21317682/E344/Reports/Assignment 2/App-A.tex

     \chapter{Appendix A: GitHub Activity Heatmap}

     \begin{figure}[!htb]
     \centering
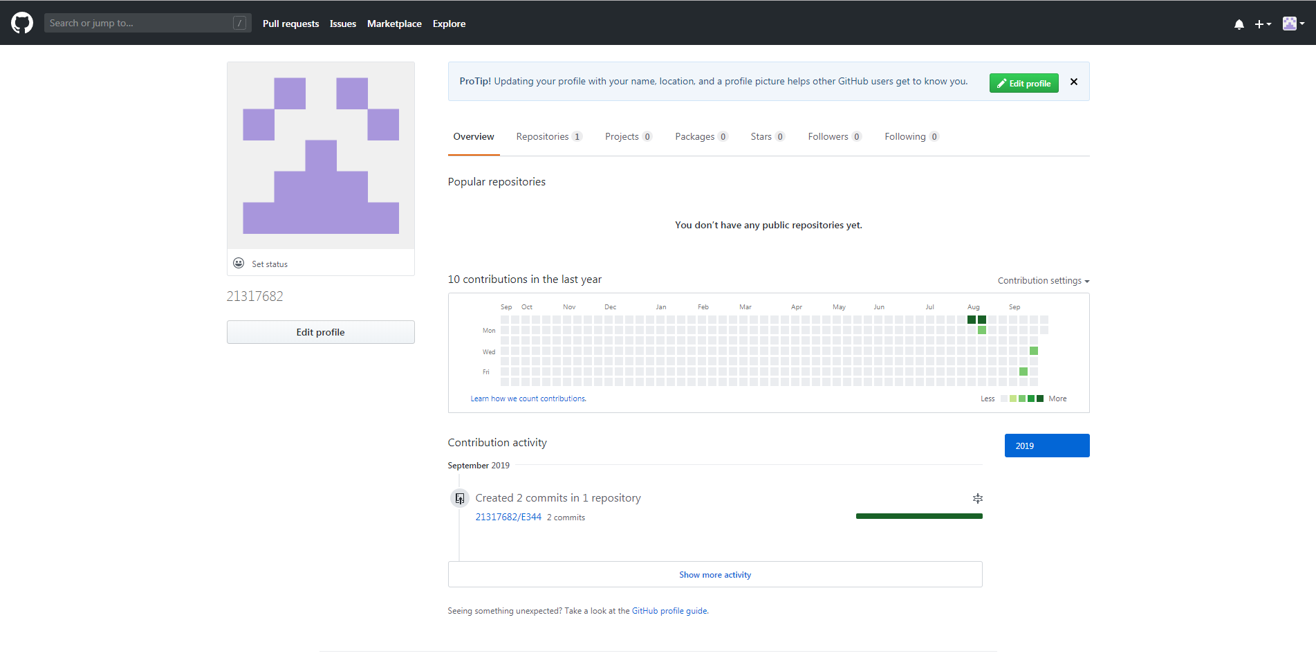
[picture p1: Reports/Assignment 2/Figures/heatmap.png]
     	\fbox{}
	\label{fig:github}
	\end{figure}
