21317682/E344/Reports/Assignment 2/declaration.tex

   \chapter{Declaration}

By submitting this report electronically, I declare that the entirety of the work contained
therein is my own, original work, that I am the sole author thereof (save to the extent
explicitly otherwise stated), that reproduction and publication thereof by Stellenbosch
University will not infringe any third party rights and that I have not previously in its
entirety or in part submitted it for obtaining any qualifcation.

\vspace{3cm}
\hspace{2cm}
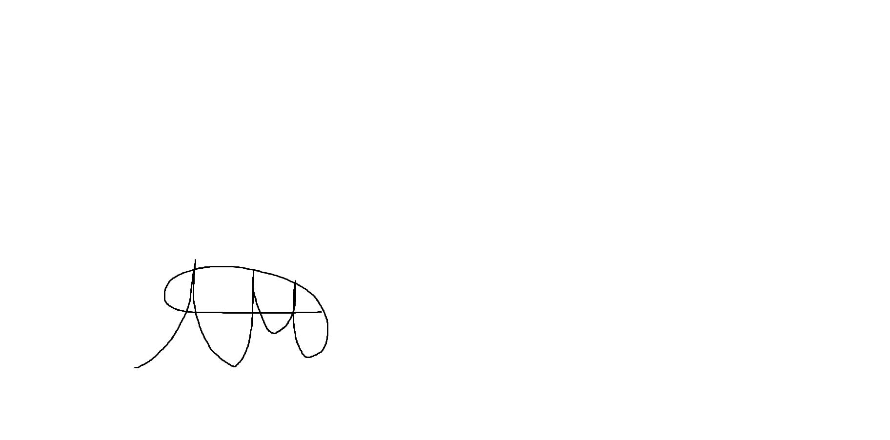
[picture p16: Reports/Assignment 2/Figures/Signature-Alex.png]
\\
\noindent%
\parbox{.5\textwidth}{%
  Signature:\quad\dotfill\par
  \hfill A.\ Muthua\hspace{1.2cm}\null}

\vspace{1.2cm}
\hspace{2cm}
\today \\
\noindent%
\parbox{.5\textwidth}{%
  Date:\quad\dotfill\par}
