21317682/E344/Reports/Assignment 1/App-C.tex

     \chapter{Appendix C: Screengrab of GitHub repo}
     \vspace{-15mm}
     \begin{figure}[!htb]
     \centering
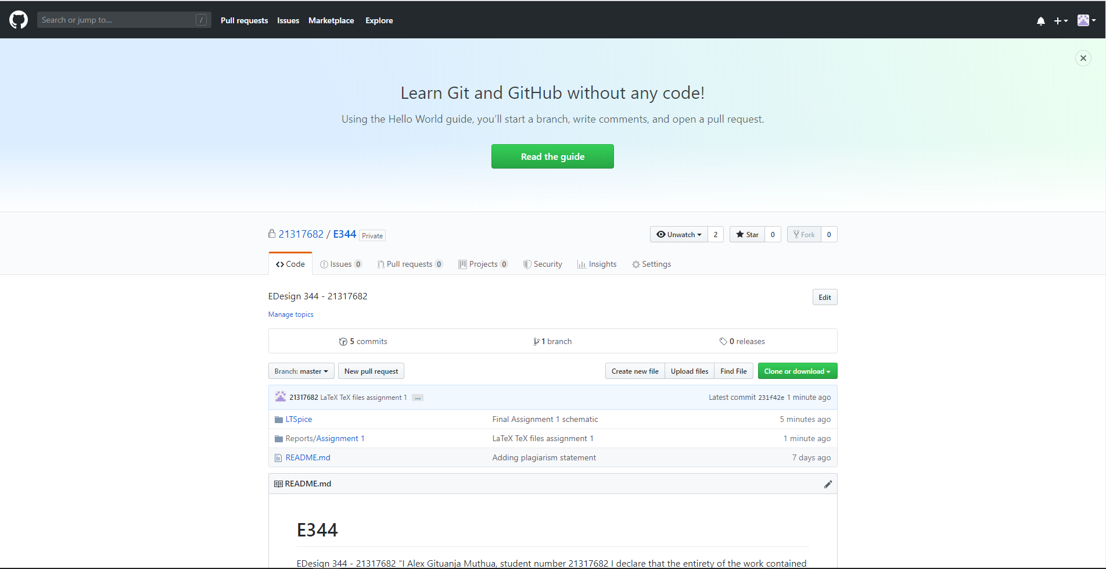
[picture p17: Reports/Assignment 1/Figures/github_repository_A1.PNG]
     	\fbox{}
	\label{fig:github}
	\end{figure}
