21317682/E344/Reports/Assignment 1/App-B.tex

     \chapter{Appendix B: Wiring safety check}
     \vspace{-15mm}
     \begin{figure}[!htb]
     \centering
     	\fbox{}
	\label{fig:plugSafety}
	\end{figure}
