21317682/E344/Reports/Assignment 1/Muthua_21317682_A1.pdf

1

August 11, 2019

## Report for E-design 344

by

## Alex Muthua

21317682

E-Design report # 1

0

# Declaration

By submitting this report electronically, I declare that the entirety of the work contained therein is my own, original work, that I am the sole author thereof (save to the extent explicitly otherwise stated), that reproduction and publication thereof by Stellenbosch University will not infringe any third party rights and that I have not previously in its entirety or in part submitted it for obtaining any qualifcation.


Signature: |
A. Muthua

August 11, 2019
Date: |

i

# Contents

Declaration | i
Contents | ii
List of Figures | iv
List of Tables | v
Nomenclature | vi
1 Power supply system design | 1
2 Rectifier | 2
3 Switchmode regulation | 4
4 Linear regulation | 7

ii

CONTENTS | iii
5 Charge pump regulation | 10
6 System test results | 13
References | 14
Appendix A: Social contract | 15
Appendix B: Wiring safety check | 16
Appendix C: Screengrab of GitHub repo | 17

# List of Figures

1.1 | System diagram | | 1
2.1 | Half wave rectifier circuit | | 3
2.2 | Rectifier simulated and measured output | | 3
3.1 | Switchmode regulator circuit | | 5
3.2 | Simulated switchmode output | | 6
3.3 | Switchmode output voltage | | 6
3.4 | Switchmode measured output | | 6
4.1 | Linear regulator circuit | | 8
4.2 | Simulated +5V output | | 9
4.3 | +5V measured output | | 9
5.1 | Charge pump circuit | | 12
5.2 | Simulated +5V output | | 12
5.3 | -5V measured output | | 12

iv

# List of Tables

v

# Nomenclature

Constants
g = 9.81 m/s

2

Variables

C | Capacitance | | [ F ]
Q | Charge | | [ C ]
i | Current | | [ A ]
P | Power | | [W ]
R | Resistance | | [ Ω ]
Θ | Thermal resistance | | [

oC/W ]

V | Voltage | | [ V ]

Abbreviations
BJT | | Bipolar Junction Transistor
MOSFET | | Metal Oxide Semiconductor Field Effect Transistor
AC | | Alternating Current
DC | | Direct Current

vi

# Chapter 1

# Power supply system design

## 1.1 System overview

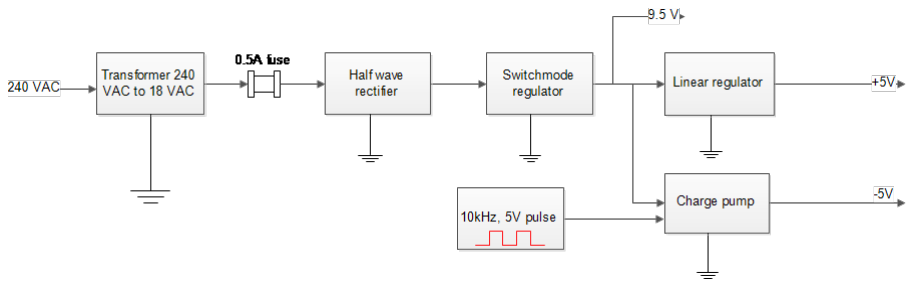
[picture p25: figure]

Figure 1.1: System diagram

## 1.2 Rationale

The 240 VAC to 18 VAC transformer was provided for this design, to avoid the risk associated with working directly with the mains supply voltage. As only a half wave rectifier is implemented in the design the AC return can be directly connect to the DC ground. The rectifier provides a positive voltage that is passed through two stages of regulation.
The switchmode regulator is connected to the rectifier as it is more efficient at higher input voltages [1]. However,it produces significant noise in its output which is unwanted in this device’s application. So, the switchmode is adjusted to give an intermediate voltage that drives a linear regulator to give a 5 V supply, and a charge pump scheme to supply −5 V.This allows for minimal noise in the 5 V rail, and increases the efficiency of the charge pump scheme.

1

# Chapter 2

# Rectifier

## 2.1 Theory and related work

A basic half-wave rectifier consists of a diode in series with a sinusoidal input voltage. This allows only the positive cycle of the input to appear at the output. Adding a shunt/filter capacitor to the rectifier’s output allows for current to flow continuously as the capacitor discharges during the cutoff period of the diode [2].

## 2.2 Design

Design rationale
For this design, the main consideration is that the capacitor is large enough to supply current to the rest of the circuit at the required voltage. This is calculated in Equation 2.1. However, the current flowing through the diode is also a concern as a 0.5 A fuse is installed in the design. So, it must be ensured that any transient charging currents are not large or sustained enough that the fuse blows. The 1N4007 diode used here has a peak reverse voltage of 700 V[3] which is more than sufficient. Design calculations
Capacitor calculation:

dQ = i × dt = C(Vpk − Vmin)

C =

200 mA × 0.02
18 √
2 − 0.7 − 12

= 313.6 µF

(2.1)

Ideally, a 330 µF capacitor would be used. However, due to the voltage rating of the available capacitors, two 220 µF capacitors were instead used.

2

r

s

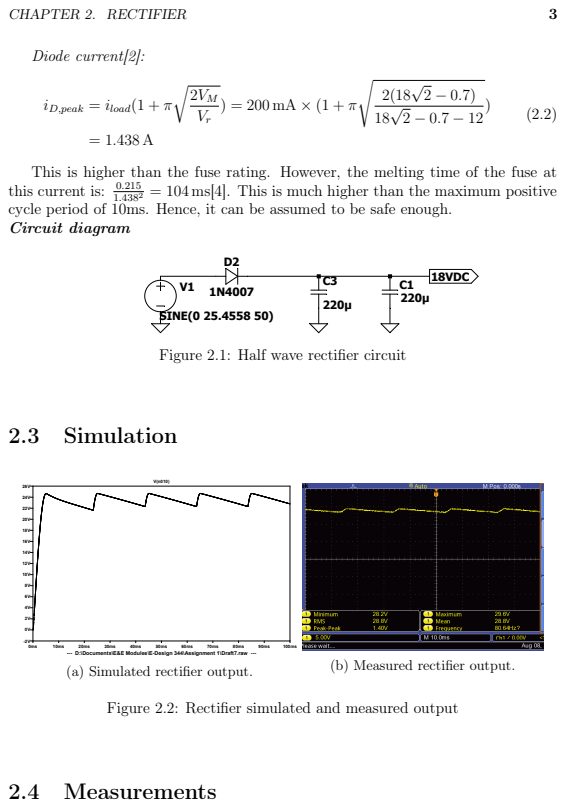
[picture p26: page 11]
CHAPTER 2. RECTIFIER; Diode current[2]:; SINE(0 25.4558 50); 18VDC; 2.3 Simulation; (a) Simulated rectifier output.; (b) Measured rectifier output.; 2.4 Measurements

iD,peak = iload(1 + π

This is higher than the fuse rating. However, the melting time of the fuse at
this current is: 0.215
cycle period of 10ms. Hence, it can be assumed to be safe enough.
Circuit diagram

1.438² = 104 ms[4]. This is much higher than the maximum positive

Figure 2.1: Half wave rectifier circuit

--- D:\Documents\E&E Modules\E-Design 344\Assignment 1\Draft7.raw ---

Figure 2.2: Rectifier simulated and measured output

# Chapter 3

# Switchmode regulation

## 3.1 Theory and related work

Switchmode regulators operate by rapidly switching an energy storage device on and off. The duty cycle and frequency of the switch sets how much charge is transferred to the load. This, in turn determines the output voltage of the regulator. These regulators can be used to step down(buck) or step up(boost) a given input voltage. The series storage device is usually either fully conducting or switched off, thus, the regulator tends to dissipate almost no power. This gives it quite a high efficiency. Due to the switching operation of the regulator, it produces a significant ripple voltage at its output. However, it is a much better choice if the input voltage is much higher than the output voltage [1].

## 3.2 Design

Design rationale
As explained in Section 1.2, the switchmode regulator is used to give an intermediate voltage of that is then passed through the linear regulator designed in Section
4.2. This intermediate voltage is also used to power the charge pump scheme in Section 5.2. The intermediate voltage is chosen as 9.5 V as shown to be sufficient in Section 5.2.
In terms of the design of the regulator, the device’s datasheet provides a sufficient circuit that is implemented in the design [5].The components listed below and shown in Figure 3.1 are all chosen based of [5], which provides the appropriate values to use for a wide reange of applications.
- A low ESR capacitor is required at the input pin to prevent large voltage transients from appearing, and to provide the instantaneous current required each time the switch turns on.

4

CHAPTER 3. SWITCHMODE REGULATION | 5
- A feedforward capacitor adds lead compensation to the feedback loop and increases the phase margin for better loop stability.
- An output capacitor is required to filter the output and provide regulator loop stability. Low impedance/ ESR capacitors designed for switching regulator applications must be used.
- Buck(step-down) regulators require a diode to provide a return path for the inductor current when the switch turns off. Because of their very fast switching speed and low forward voltage drop, Schottky diodes provide the best performance.
- An inductor at the output is used to store energy such that current continuously flows, even when the regulator is "switched off". An inductor of 330 µH is suggested, but a smaller inductor is already provided. So, it is used as it will provide just as much or more continuous current.
- Resistors, R1 and R2 in Figure 3.1, are used to adjust the output voltage as shown in Equation 3.1.

Design calculations
Feedback resistors/ Adjusting voltage output [5]:

Vout = (1 + R1
R2

)Vref

R1 = R2(

Vout

Vref

− 1) = 1k(

9.5
1.23

− 1)

= 6.724 kΩ

(3.1)

A 10 kΩ variable resistor is placed at R1 and set to give the required output voltage. Circuit diagram

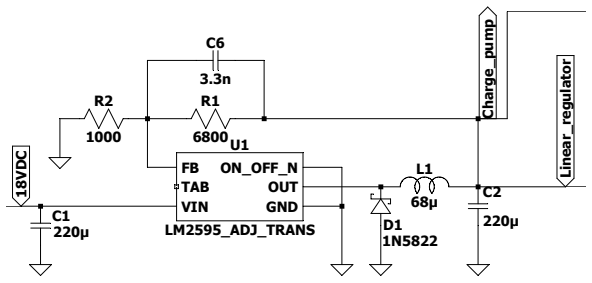
[picture p27: figure]
FB TAB VIN; ON_OFF_N OUT GND; LM2595_ADJ_TRANS; Linear_regulator 18VDC; Charge_pump

Figure 3.1: Switchmode regulator circuit.

## 3.3 Simulation

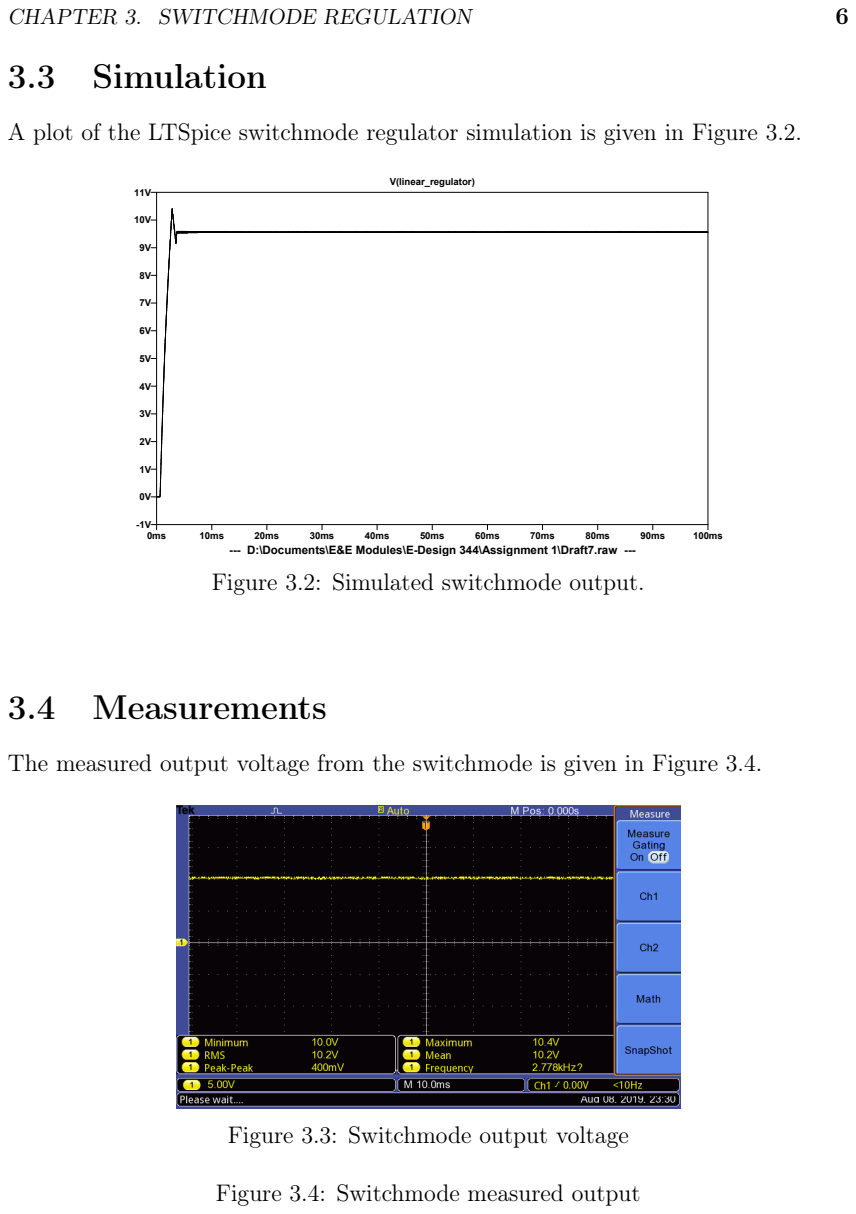
[picture p28: page 14]
CHAPTER 3. SWITCHMODE REGULATION; V(linear_regulator); 3.4 Measurements

A plot of the LTSpice switchmode regulator simulation is given in Figure 3.2.

--- D:\Documents\E&E Modules\E-Design 344\Assignment 1\Draft7.raw ---
Figure 3.2: Simulated switchmode output.

The measured output voltage from the switchmode is given in Figure 3.4.

Figure 3.3: Switchmode output voltage

Figure 3.4: Switchmode measured output

# Chapter 4

# Linear regulation

## 4.1 Theory and related work

Linear regulators behave like variable resistance devices, where the internal resistance is varied in order to maintain a constant output voltage. In reality, the variable resistance is provided by means of a transistor controlled by an amplifier feedback loop. They reject any input voltage ripple and are able to produce steady voltage outputs with very little noise. However, they are quite inefficient as they dissipate the difference between the input and output voltage as heat. Thus, they are a poor choice if the output voltage is much lower than the input voltage, as is the case in this design [1].

## 4.2 Design

Design rationale As explained in Section 1.2, the linear regulator is used to remove the noise produced by the switch-mode regulator. For efficient working of the linear regulator, the input voltage should not be too high. The maximum such voltage is calculated in Equation 4.1 below.
The input and output capacitors are taken from the device datasheet [6]. The input capacitor is not included in the design since the input pin is connected to the output of the switch-mode regulator, that already has a 220 µF capacitor. This is much larger than the 330 nF specified. A 100 nF output capacitor is included to improve the transient response.
Design calculations

7

CHAPTER 4. LINEAR REGULATION | 8

Input voltage:

Pdissipated,max = Vin,maxIin − VoutIload

Pdissipated,max =

TJ,max − Tair

ΘJA

=

150 − 25
150

= 833.33 mW

Vin,max =

Pdissipated,max + VoutIload

Iload + IQ

=

0.8333 + (5 × 100m)
100m + 2m
= 13.072 V

(4.1)

A 9.5 V input is chosen as it meets the above requirement as well as that of the charge pump in Section 5.2.

Circuit diagram
U2

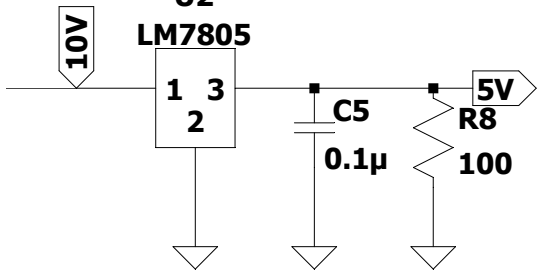
[picture p29: figure]
5V ¹⁰V

Figure 4.1: Linear regulator circuit.

## 4.3 Simulation

A plot of the LTSpice linear regulation simulation is given in Figure 4.2.

## 4.4 Measurements

A plot of the measured output voltage from the linear rectifier is given in Figure
4.3. This contains both the DC voltage level (Figure 4.3a) as well as the noise levels under AC coupling (Figure 4.3b).

CHAPTER 4. LINEAR REGULATION | 9
0ms | 10ms | 20ms | 30ms | 40ms | 50ms | 60ms | 70ms | 80ms | 90ms | 100ms

-0.5V

0.0V

0.5V

1.0V

1.5V

2.0V

2.5V

3.0V

3.5V

4.0V

4.5V

5.0V

5.5V

V(5v)

--- D:\Documents\E&E Modules\E-Design 344\Assignment 1\Draft7.raw ---
Figure 4.2: Simulated +5V output.

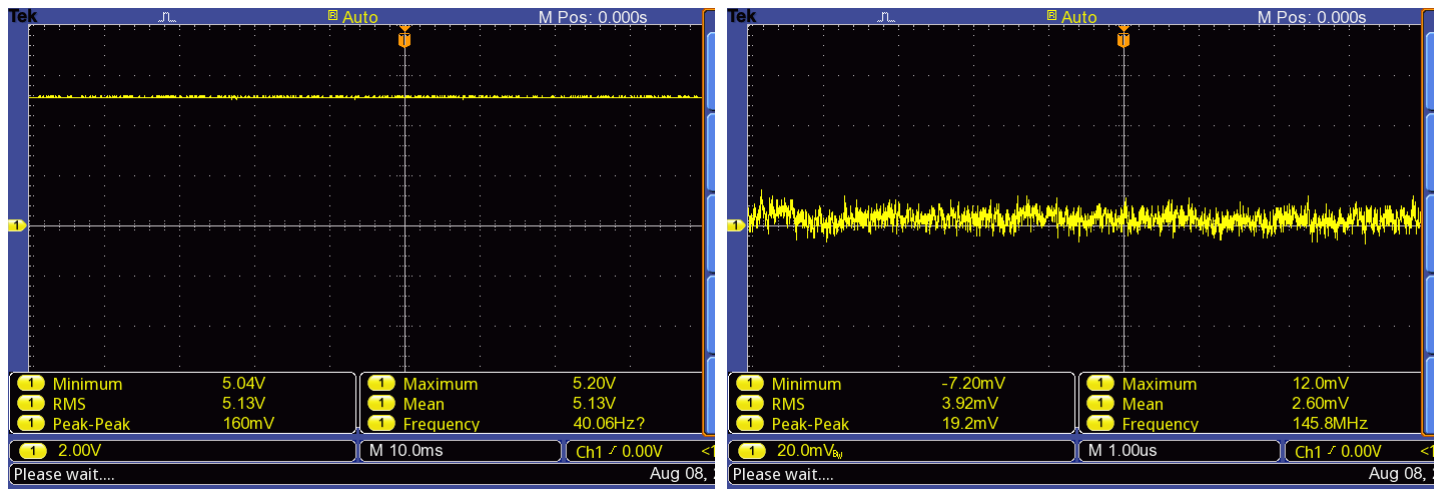
[picture p30: figure]

(a) +5V output voltage | (b) +5V noise levels.

Figure 4.3: +5V measured output

# Chapter 5

# Charge pump regulation

## 5.1 Theory and related work

A charge pump is an electronic circuit that converts a supply voltage to a DC output voltage that is several times higher. Unlike the other traditional DC-DC converters, which employ inductors, charge pumps are only made of capacitors and switches (implemented by diodes or MOSFETs) [7]. The arrangement of these switches, allows for the charge pump to be used as a voltage doubler (or multiplier with extra stages) or as a voltage inverter [8].

## 5.2 Design

Design rationale As standard diodes are to be used as the switches in the design, the diode voltage drops have to be accounted for [8]. This means that the 5 V amplitude clock cannot be connected directly into the charge pump scheme if a −5 V output is to be achieved. Thus, an amplifier stage is implemented to boost the clock to a sufficiently high amplitude.
This is achieved using one of the provided BJTs. In order to provide isolation to the amplifier stage, a pair of BJTs are connected between the amplifier and the charge pump. These are set to alternatively switch on and off, thus providing a path for current to flow during charging and discharging of the charge pump’s flying capacitor without affecting the operation of the amplifier. To achieve this alternate switching, the amplifier is designed to be inverting and its output connected to the first of the transistors. The second switching transistor is then connected to the input clock to finalise the transistor switching scheme.
The amplifying transistor is designed to be in saturation or cutoff, to maximise its output [2]. The switching transistors only had a base resistor, as this helped to increase the efficiency of the charge pump. All the resistors were adjusted in

10

CHAPTER 5. CHARGE PUMP REGULATION | 11

simulation such that the charge pump could supply enough current to its load. Reducing the size of the resistors helped achieve this.
The arrangement of the capacitors and diodes was obtained from [8]. The capacitors should be large enough to store the charge lost to the load each cycle, but not so large that they cannot fully charge up. From Figure 5.1, C4 should be larger than C7 as it has to supply charge to the load, as well as charge up capacitor C7 when it discharges. C7 has to be large enough to avoid a significant ripple appearing at the output.
To provide some load regulation to the charge pump, a Zener diode is connected to its output [2]. This clips the output at −5 V irregardless of the load connected. Since the charge pump is designed for a maximum load of 25 mA, there is no risk of exceeding the power rating of the Zener. Finally, a filter is connected to the output of the charge pump. This helps remove the 10 kHz noise induced by the clock, as well as any 150 kHz noise from the switchmode regulator.

Design calculations
Efficiency:

Psupplied =

V

2
load
Rload

=

(−5.24)²
330

= 83.2 mW

Pdelivered = Vsupply × isupply = 10.2 × 0.08 = 816 mW

Eff iciency, η =

Pdelivered

Psupplied

η =

0.0832
0.816

= 10.196%

The efficiency of the charge pump is extremely low. This can be attributed to power losses throught the Zener diode. Ideally, voltage regulation would be achieved by changing the duty cycle of the clock [9], but since that was not possible here all the excess current that the charge pump produces is dumped into the Zener. Thus, the charge pump’s efficiency becomes poorer the lower its load is.

Circuit diagram
The circuit diagram implemented for the charge pump is given in Figure 5.1.

## 5.3 Simulation

## 5.4 Measurements

The measured DC voltage level (Figure 5.3a) as well as the noise levels under AC coupling (Figure 5.3b) is shown.

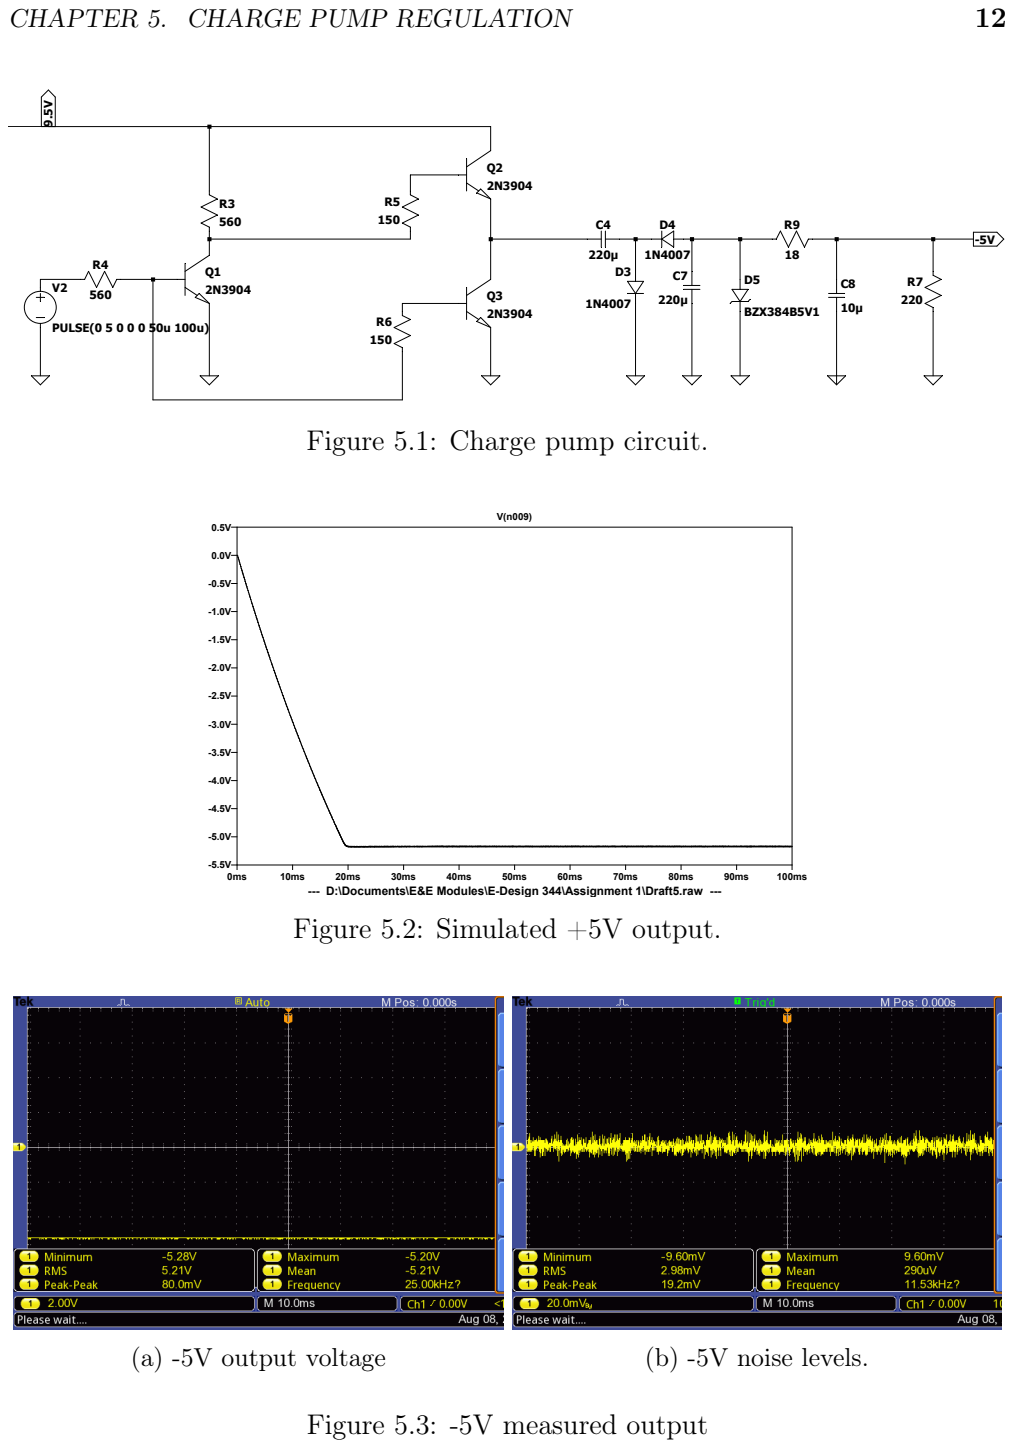
[picture p31: page 20]

Figure 5.1: Charge pump circuit.

--- D:\Documents\E&E Modules\E-Design 344\Assignment 1\Draft5.raw ---

# Chapter 6

# System test results

Table 6.1: System test results.

| Expected value | Measured value
Rectifier | ≥ 12.0 V | 28.2 to 29.6V
Switchmode regulator | ≥ 9.0 V | 10.0 to 10.4V
Linear regulator | 5.0 V | 5.04 to 5.12V
Charge pump | −5.0 V | −5.20 to −5.28V
5 V noise | ≤ 20.0 mV | 19.2 to 25.6mV
−5 V noise | ≤ 20.0 mV | 19.2 to 60.0mV

Table 6.1 gives a summary of the measurements taken from the system. They were taken under a 50 mA load on the 5 V supply, and a 15 mA load on the −5 V supply.
The rectifier and switchmode regulator performed well within the required specifications as shown. The linear regulator and charge pump were also able to achieve their DC specifications sufficiently. The noise levels on both, however was slightly higher than expected.Despite the use of a low pass filter, switching noise from the switchmode was still present at the charge pump output, especially when a load was connected. So, an improvement on the current setup, or even an additional filter at the switchmode output could be used to combat this. This second option may also help reduce the noise on the linear regulator to acceptable levels. It was also noted that the noise at the linear regulator rose by up to 5 mV when the charge pump was operating simultaneously. Thus, an alternative solution would be to limit the load that the charge pump needs to supply in future.

13

# References

[1] Teel, J.: Linear and switching voltage regulators - an introduction. 2018.
Available at: https://predictabledesigns.com/linear-and-switching-voltageregulators-introduction/
[2] Neamen, D.A.: Microelectronics: Circuit Analysis and Design. Fourth edition edn. McGraw-Hill, New York, 2010.
[3] 1N4001-1N4007 1.0A STANDARD DIODE. WTE Power Semiconductors, 2006.
[4] Axial Lead and Cartridge Fuses, 5x20 mm > Fast-Acting > 217 Series. Littelfuse Inc., October 2014.
[5] LM2595 SIMPLE SWITCHER Power Converter 150-kHz 1-A Step-Down Voltage Regulator. Texas Instruments, May 2016.
[6] MC78LXXA / LM78LXXA 3-Terminal 0.1 A Positive Voltage Regulator. Fairchild Semiconductors, March 2013.
[7] Palumbo, G. and Pappalard, D.: Charge pump circuits: An overview on design strategies and topologies. IEEE CIRCUITS AND SYSTEMS MAGAZINE, pp. 31–45, 2010. ISSN 1531-636X.
[8] Frenzel, L.: The charge-pump option to ldo and inductor-based regulators. 2016. Available at: https://www.electronicdesign.com/power/charge-pump-optionldo-and-inductor-based-regulators
[9] Schweber, B.: What is a charge pump and why is it useful? (part 2). 2017.
Available at: https://www.powerelectronictips.com/charge-pump-useful-part-2/

14

# Appendix A: Social contract

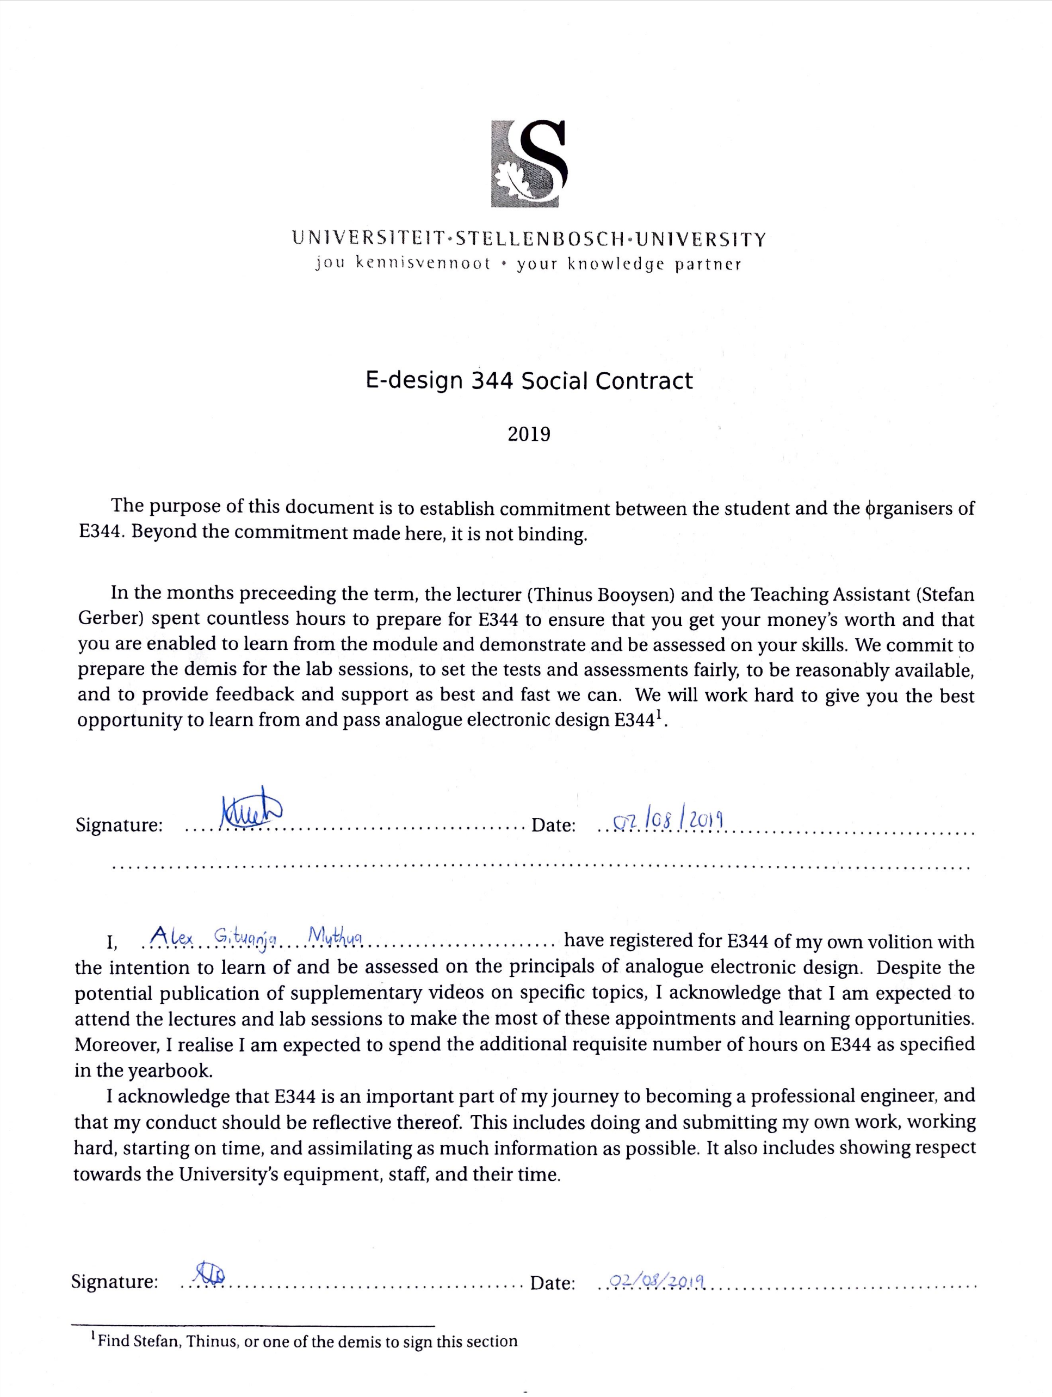
[picture p32: figure]

15

# Appendix B: Wiring safety check

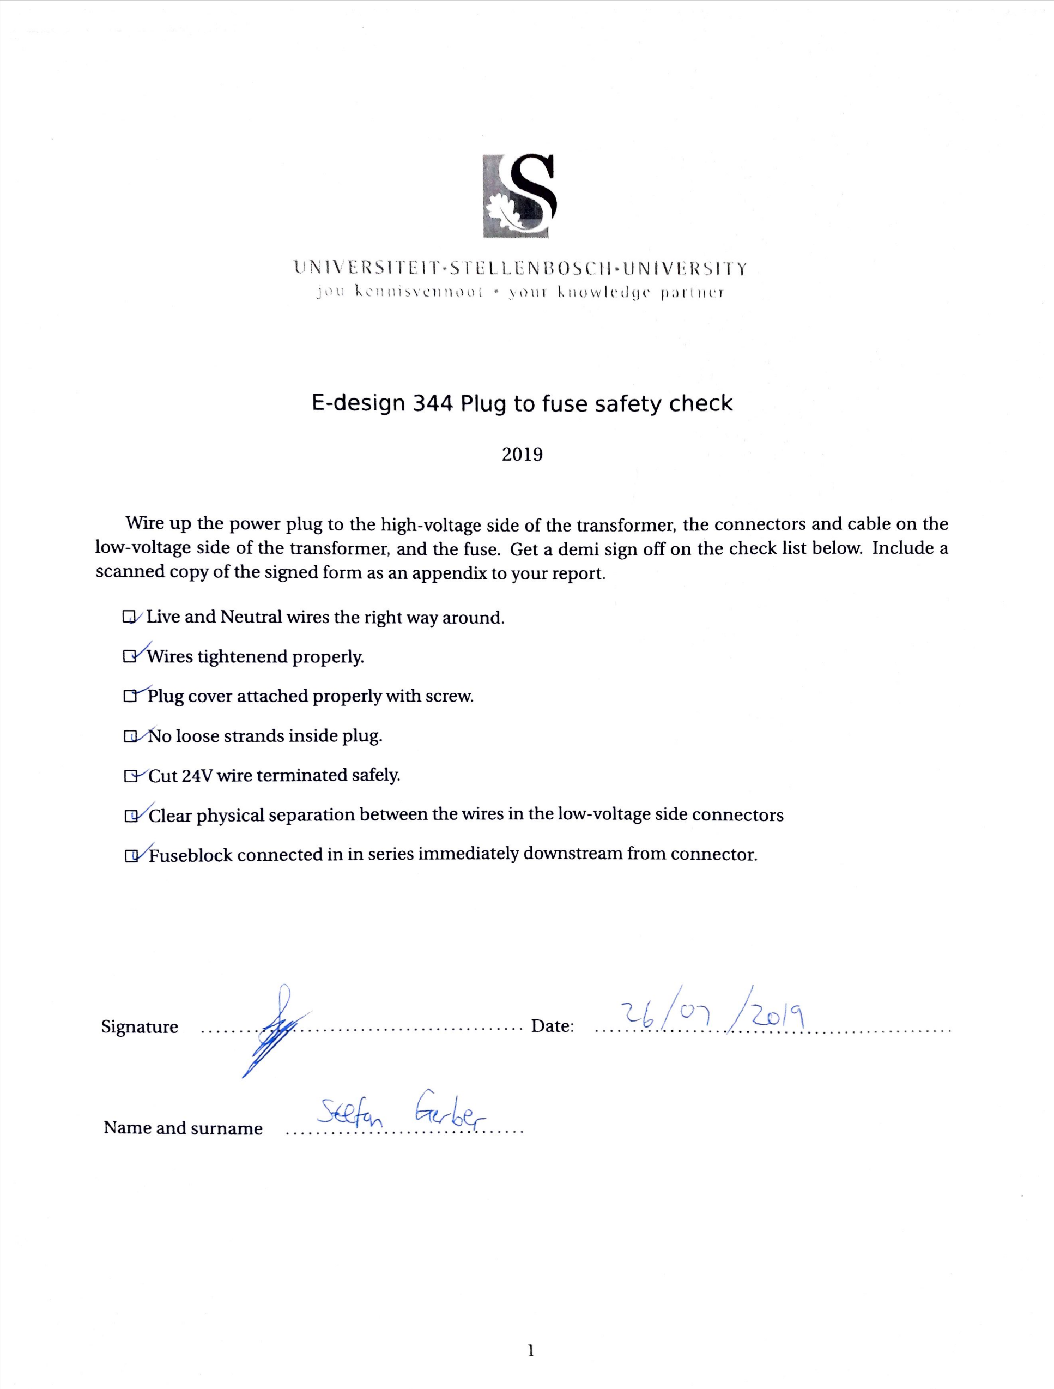
[picture p33: figure]

16

# Appendix C: Screengrab of GitHub repo


17
