21317682/E344/Reports/Assignment 1/Figures/linear_circuit.pdf

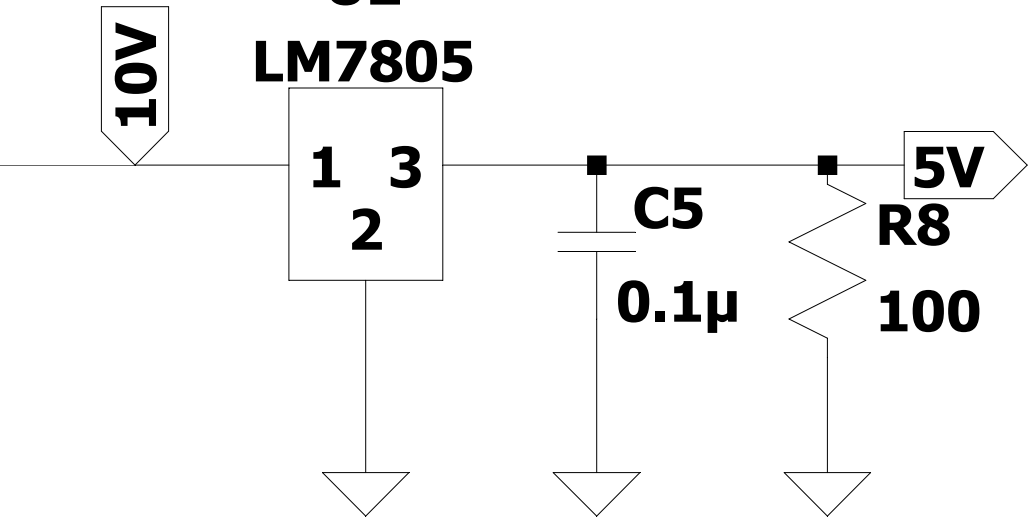
[picture p34: figure]
5V ¹⁰V

U2
