21317682/E344/Reports/Assignment 1/Figures/figure.pdf

Cost per hour of energy used for times of the day Energy per hour of energy used for times of the day

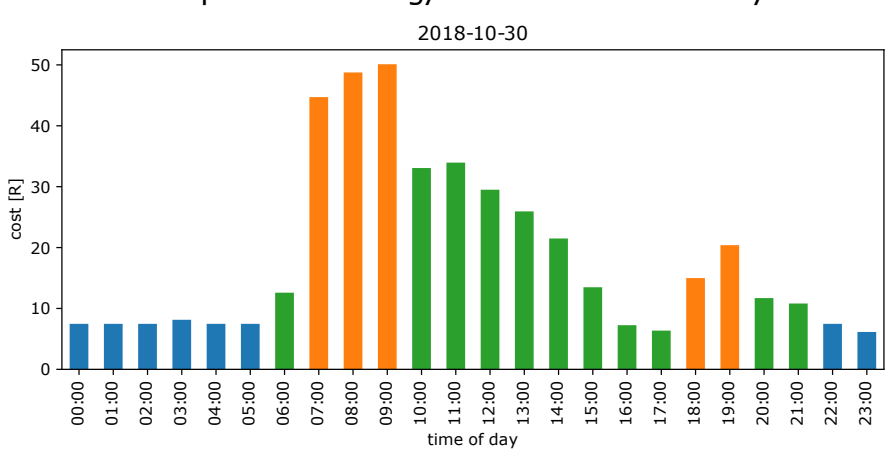
[picture p35: figure]
time of day; cost [R]
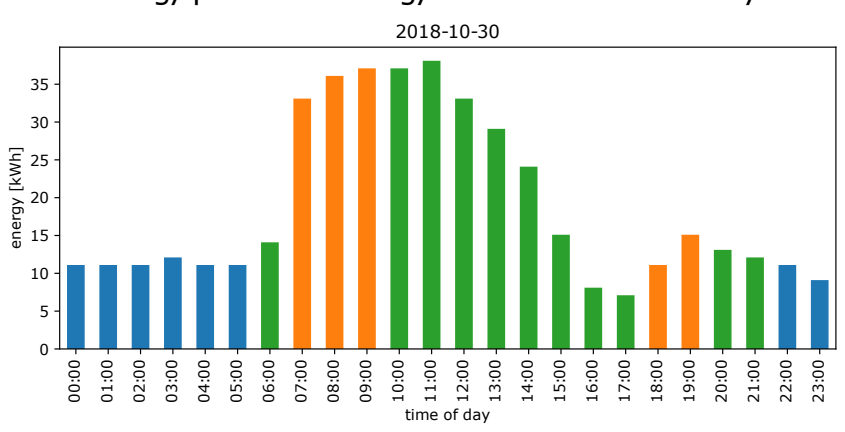
[picture p36: figure]
time of day; energy [kWh]

Breakdown of cost per day. Peak demand for the day 39 kVA Total energy for the day 449 kWh (R 441)
Of peak energy | 87 kWh
Peak energy | 132 kWh
Standard energy | 230 kWh
