21317682/E344/Reports/Assignment 1/Figures/linear_simulate.pdf

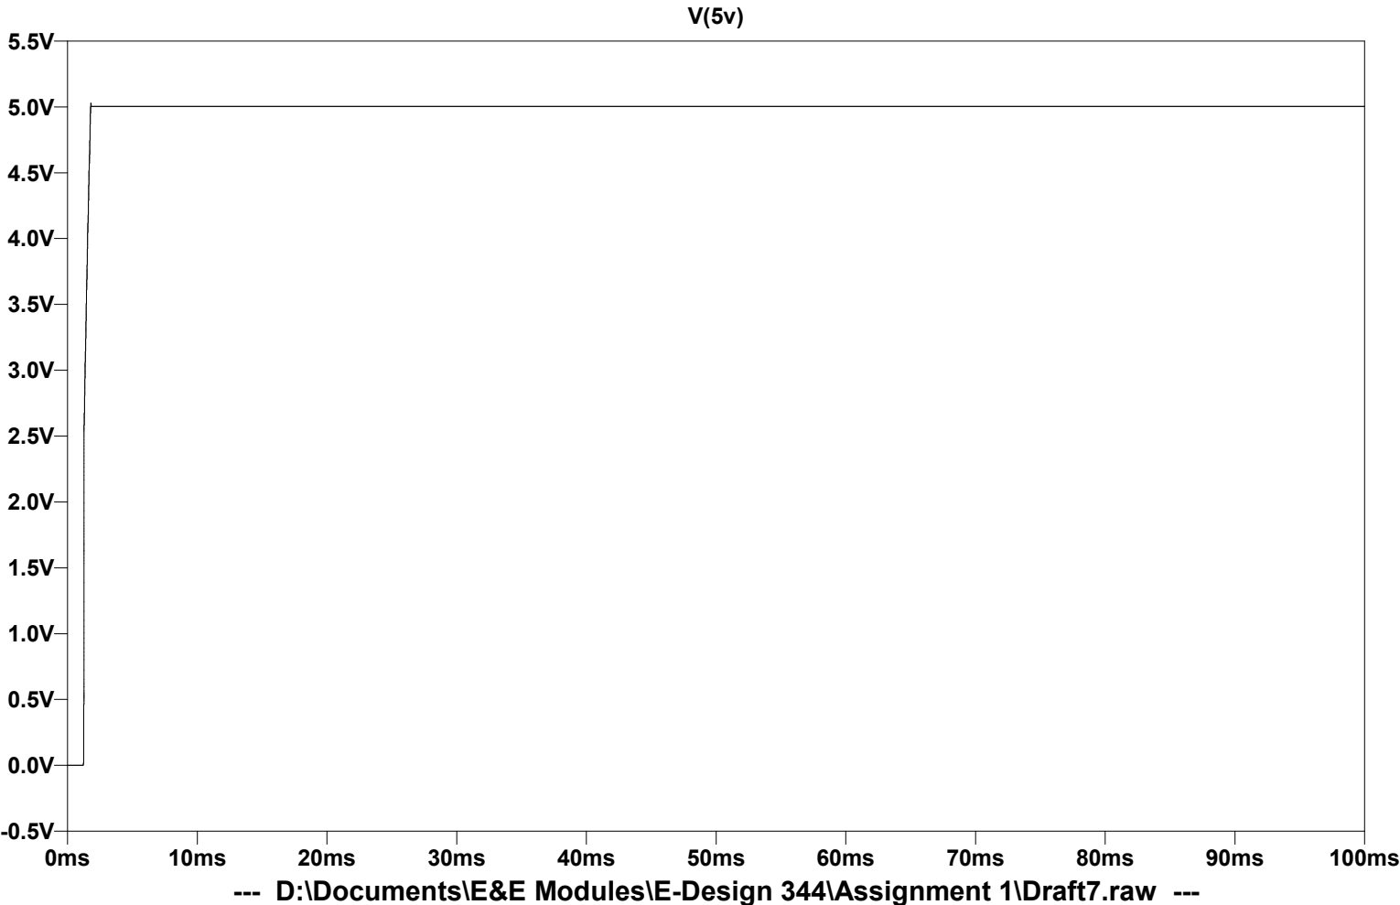
[picture p37: figure]

### --- D:\Documents\E&E Modules\E-Design 344\Assignment 1\Draft7.raw ---
