21317682/E344/Reports/Assignment 1/Figures/rectifier_circuit.pdf

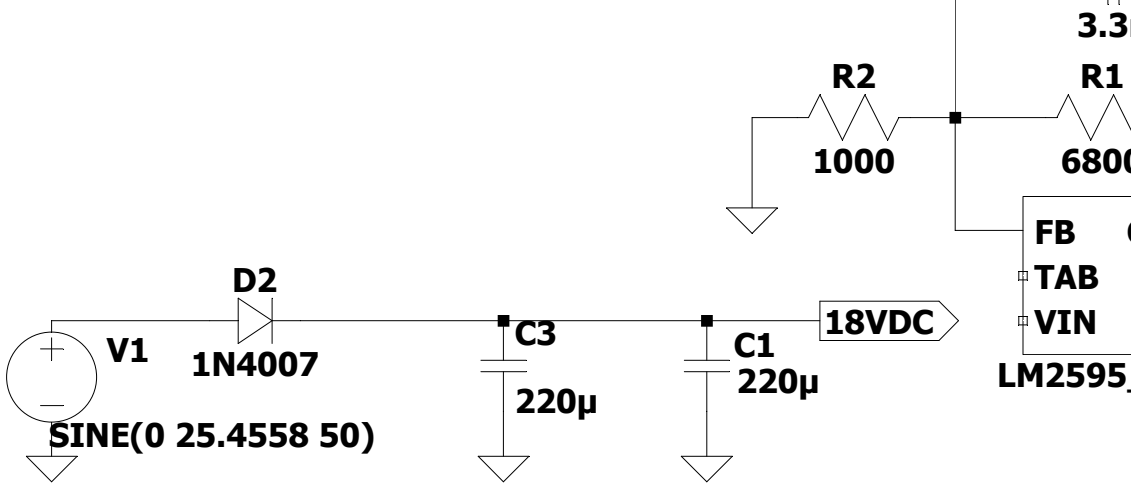
[picture p38: figure]
SINE(0 25.4558 50); FB TAB VIN; ON_OFF_N; LM2595_ADJ_TRANS; 18VDC
