21317682/E344/Reports/Assignment 1/Figures/safety_check.pdf

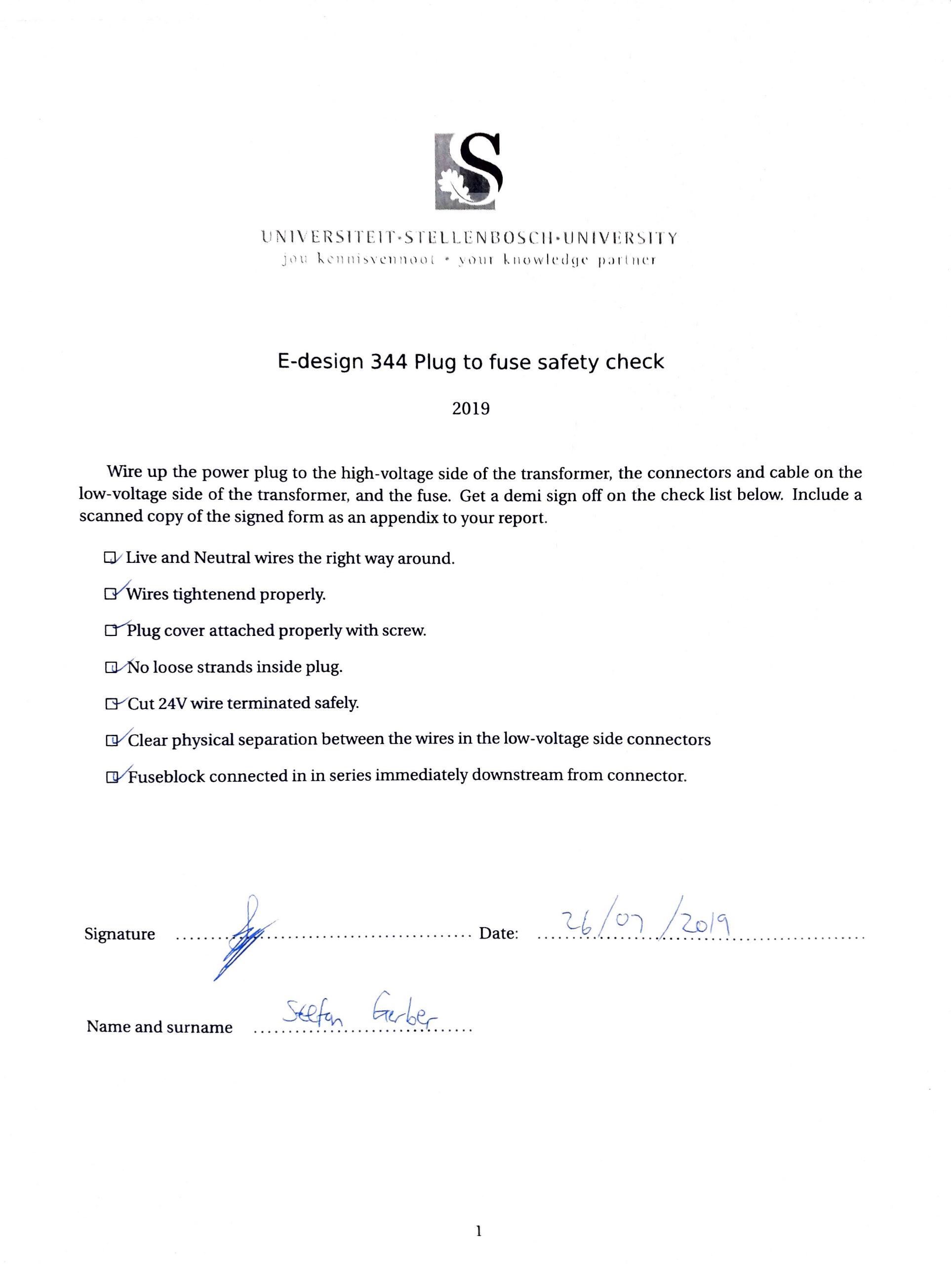
[picture p39: page 1]
