21317682/E344/Reports/Assignment 1/Figures/social_contract.pdf

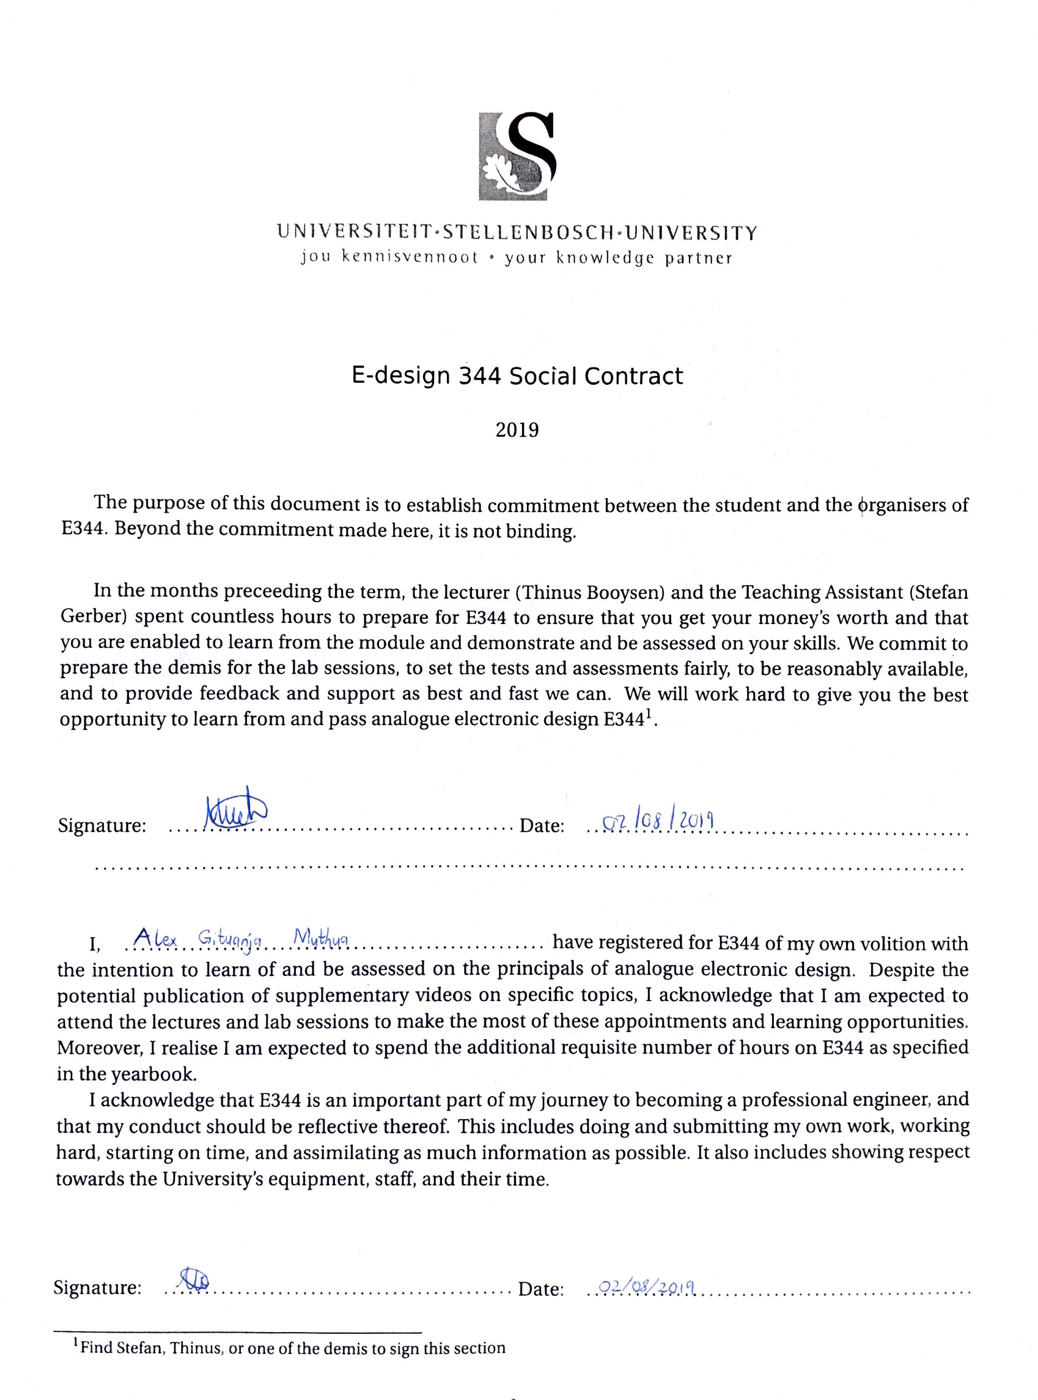
[picture p40: page 1]
