21317682/E344/Reports/Assignment 1/Figures/18vac.PNG

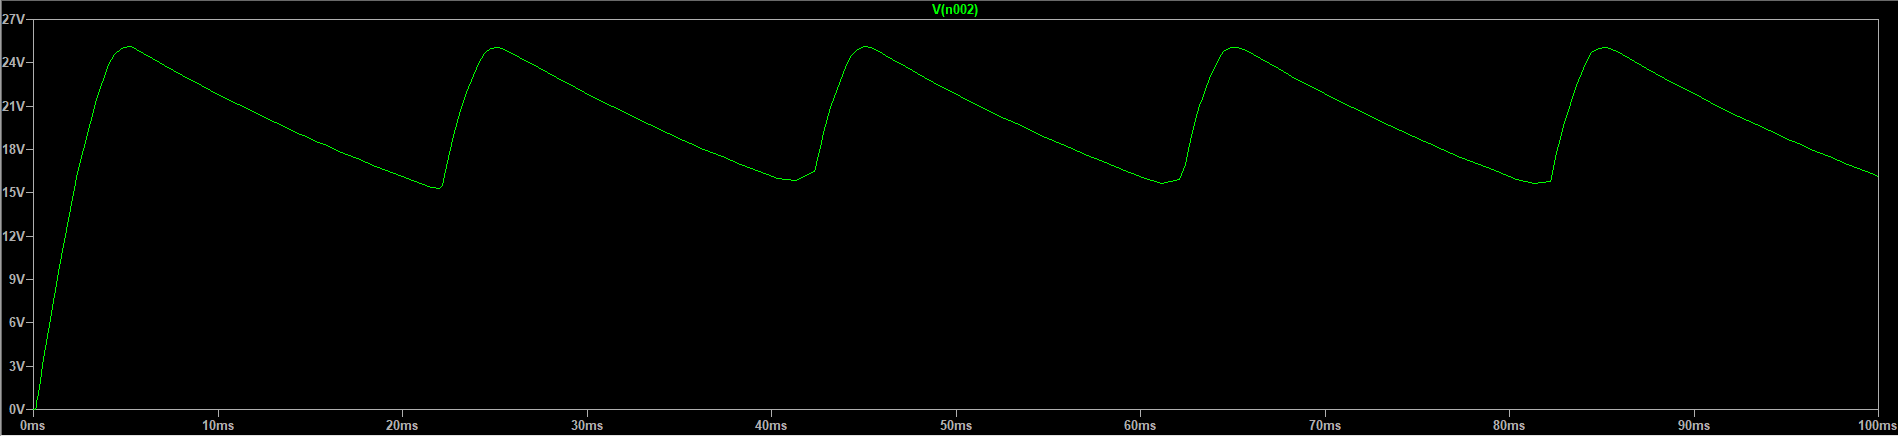
Reports/Assignment 1/Figures/18vac.PNG
