21317682/E344/Reports/Assignment 1/Figures/+5v_fft.png

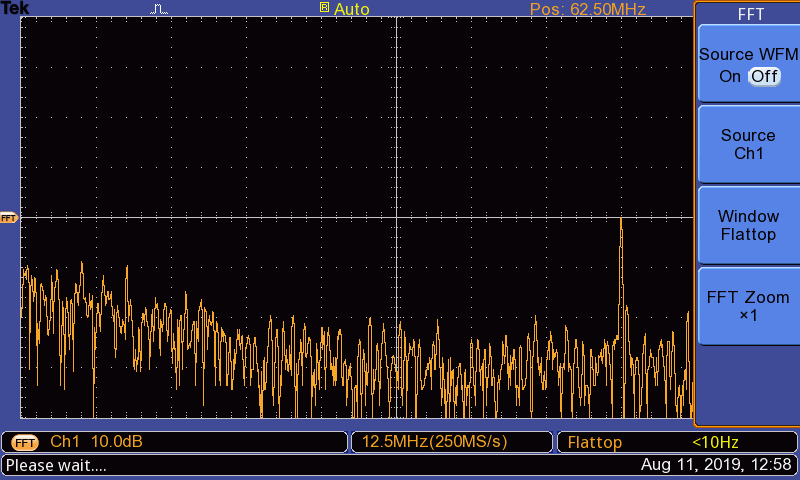
Reports/Assignment 1/Figures/+5v_fft.png
