21317682/E344/Reports/Assignment 1/Figures/GitHub.png

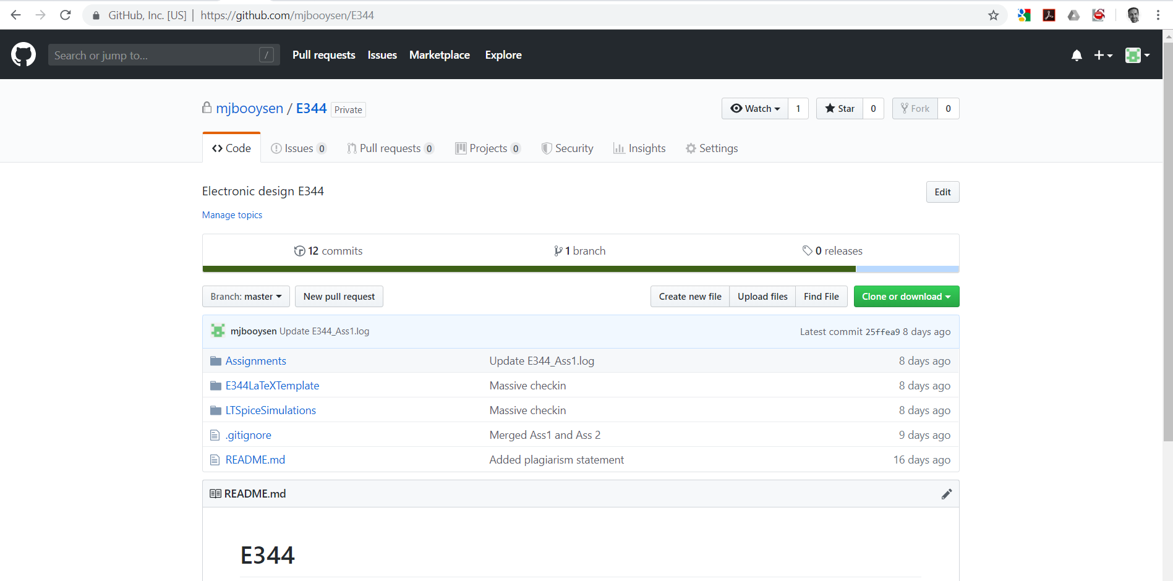
Reports/Assignment 1/Figures/GitHub.png
