21317682/E344/Reports/Assignment 2/Figures/Screengrab.png

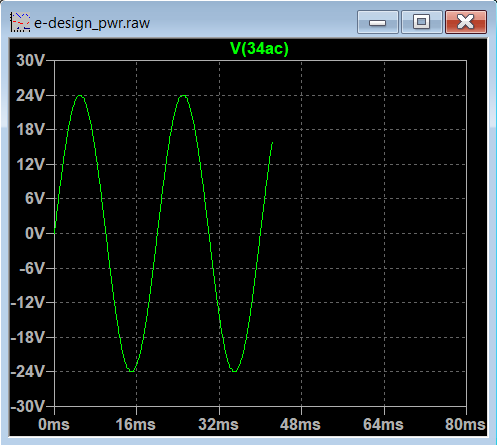
Reports/Assignment 2/Figures/Screengrab.png
