21317682/E344/Reports/Assignment 2/nomenclature.tex

\chapter{Nomenclature}

\begin{Nomencl}
 \NomGroup{Constants}%-----------------------------------------------
   \item[$\mathrm{g} = $] $\mathrm{9.81\,m/s^2}$

 \NomGroup{Variables}%-----------------------------------------------
   \item[$C$] \UnitLine{Capacitance}{F}
   \item[$Q$] \UnitLine{Charge}{C}
   \item[$i$] \UnitLine{Current}{A}
   \item[$P$] \UnitLine{Power}{W}
   \item[$R$] \UnitLine{Resistance}{$\Omega$}
   \item[$\Theta$] \UnitLine{Thermal resistance}{^oC/W}
   \item[$V$] \UnitLine{Voltage}{V}

 \NomGroup{Abbreviations}%-----------------------------------------------
   \item[BJT] \quad\dotfill Bipolar Junction Transistor
   \item[MOSFET] \quad\dotfill Metal Oxide Semiconductor Field Effect Transistor
   \item[AC]  \quad\dotfill Alternating Current
   \item[DC]  \quad\dotfill Direct Current
   \item[ADC]  \quad\dotfill Analog-to-Digital Converter
   \item[op-amp]  \quad\dotfill Operational Amplifier
   \item[XOR]  \quad\dotfill Exclusive Or Logic Gate
   \item[PWM]  \quad\dotfill Pulse-Width Modulation

\end{Nomencl}

\endinput
