21317682/E344/Reports/Assignment 2/Figures/current_transducer_simulation.pdf

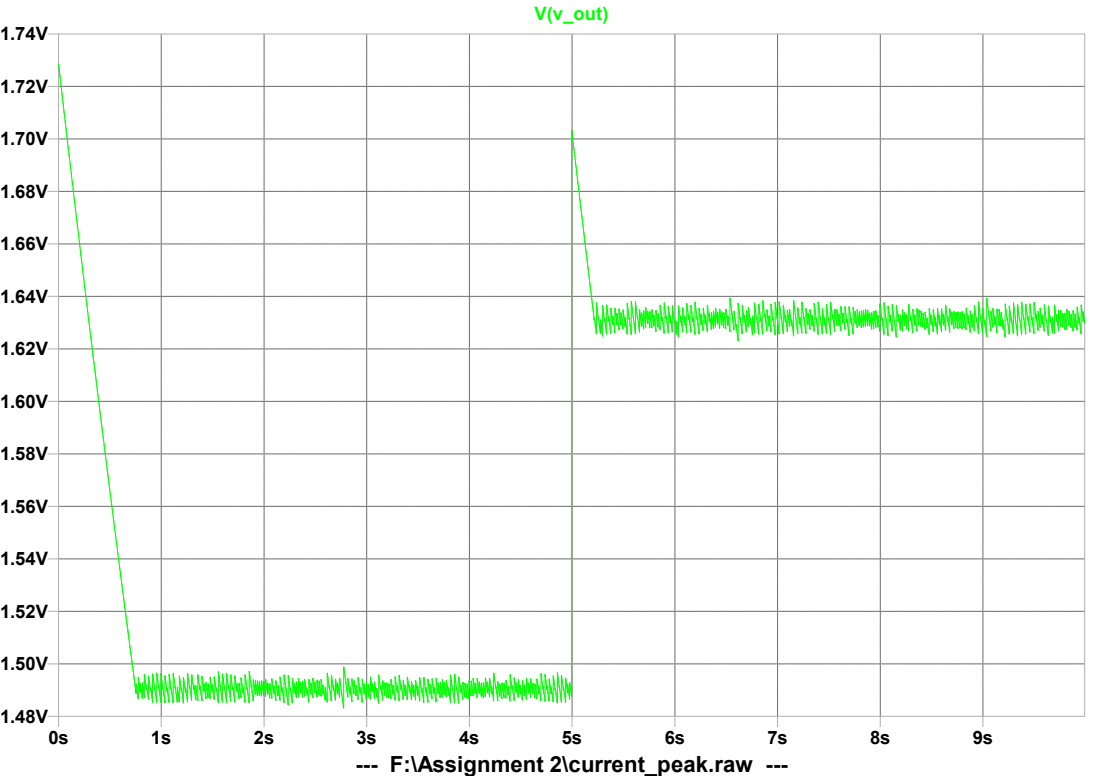
[picture p45: page 1]
V(v_out); --- F:\Assignment 2\current_peak.raw ---
