21317682/E344/Reports/Assignment 2/Figures/voltage_transducer_simulation.pdf

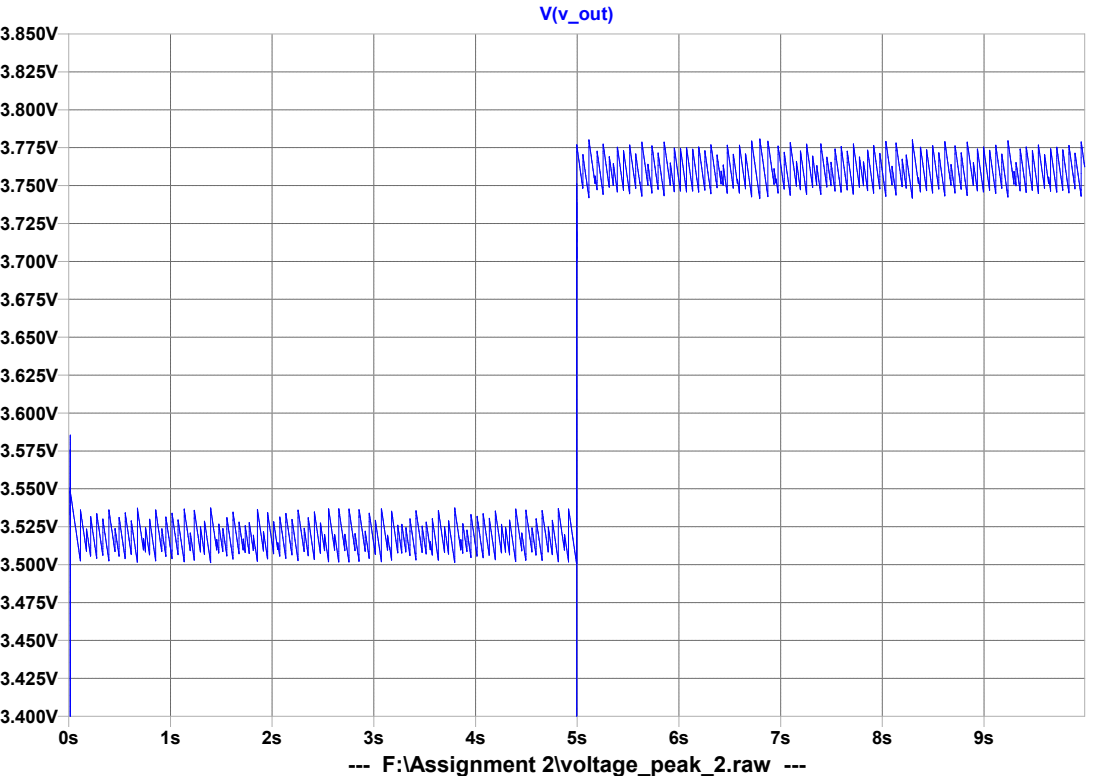
[picture p46: page 1]
V(v_out); --- F:\Assignment 2\voltage_peak_2.raw ---
