21317682/E344/Reports/Assignment 1/Figures/Circuit.pdf

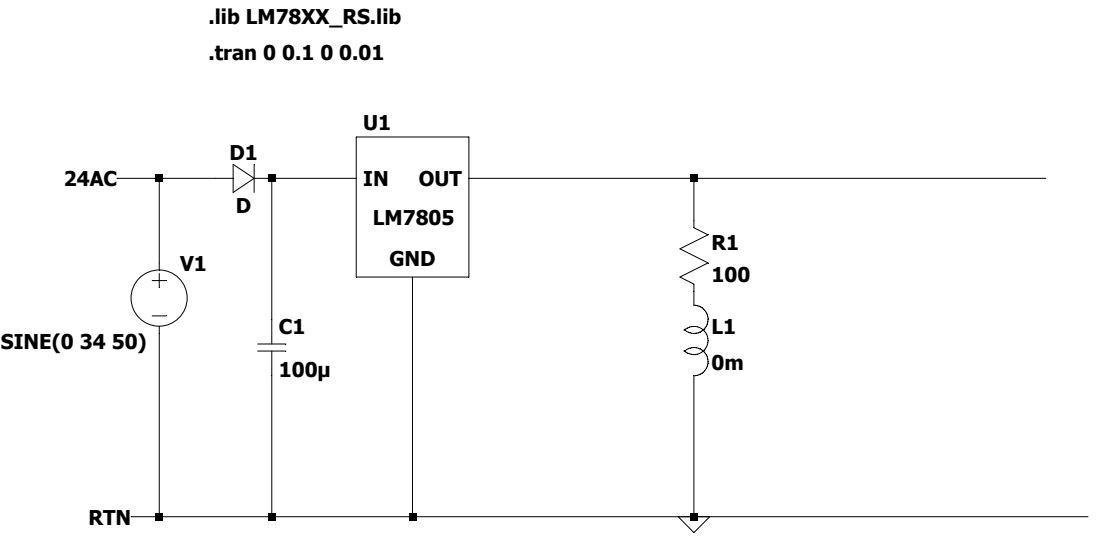
[picture p47: page 1]
SINE(0 34 50); GND; OUT; RTN; .tran 0 0.1 0 0.01; .lib LM78XX_RS.lib
