21317682/E344/Reports/Assignment 1/Figures/result8.pdf

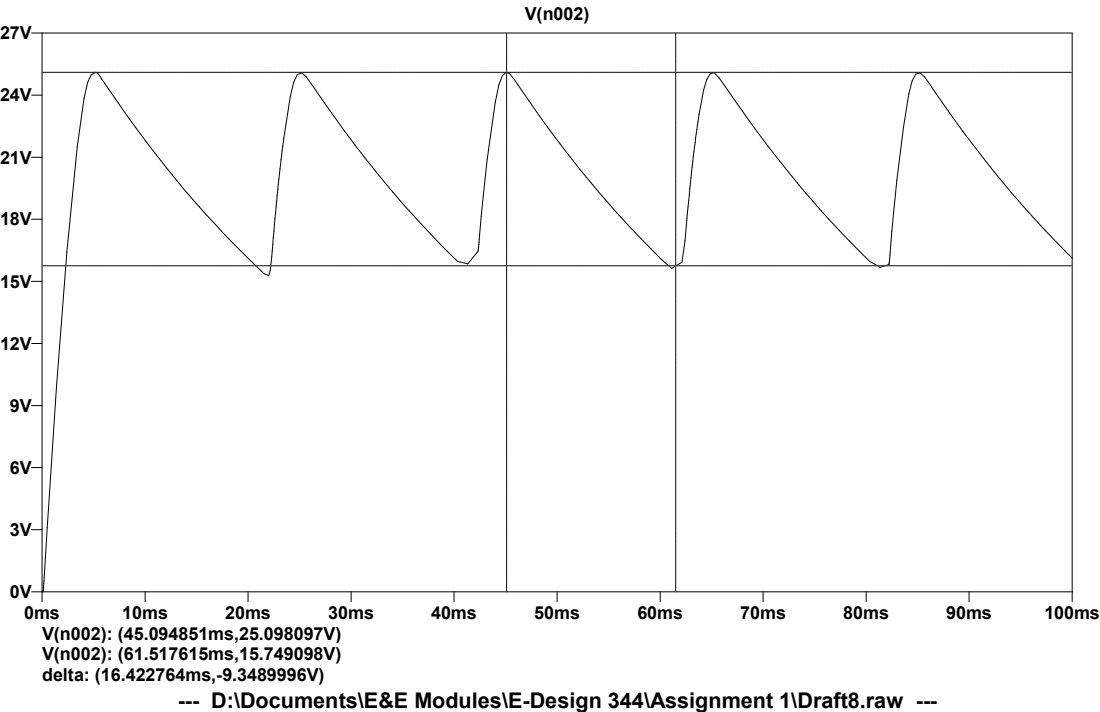
[picture p48: page 1]
V(n002): (45.094851ms,25.098097V) V(n002): (61.517615ms,15.749098V) delta: (16.422764ms,-9.3489996V)

--- D:\Documents\E&E Modules\E-Design 344\Assignment 1\Draft8.raw ---
