21317682/E344/Reports/Assignment 2/Figures/current_circuit.pdf

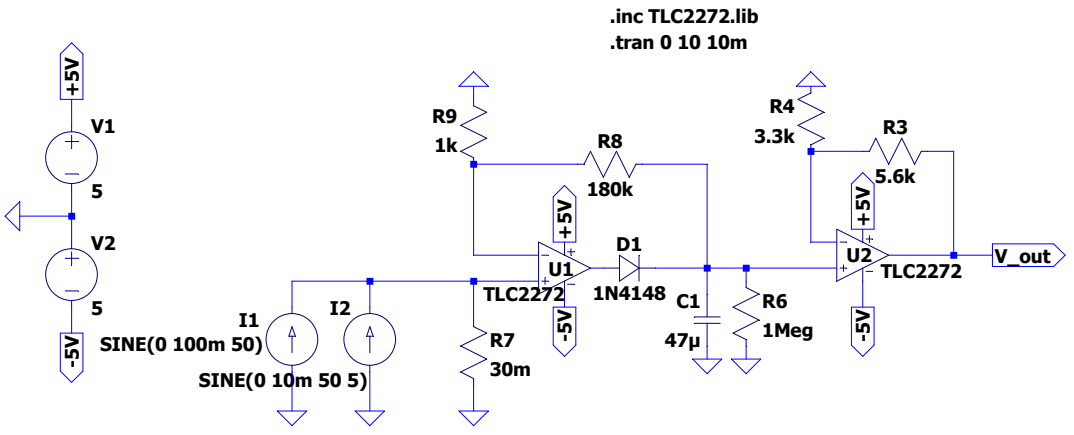
[picture p50: page 1]
