21317682/E344/Reports/Assignment 2/Figures/phase_circuit.pdf

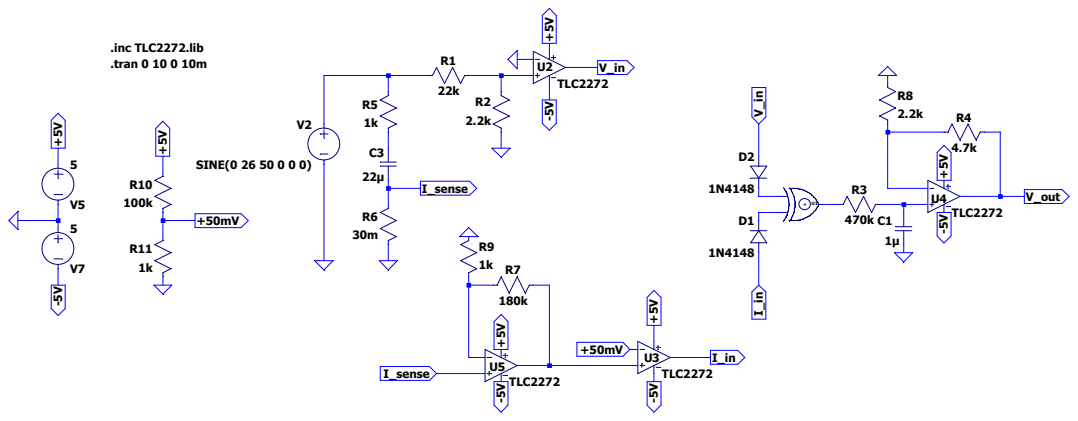
[picture p51: page 1]
