21317682/E344/Reports/Assignment 2/Figures/phase_transducer_simulation_22u.pdf

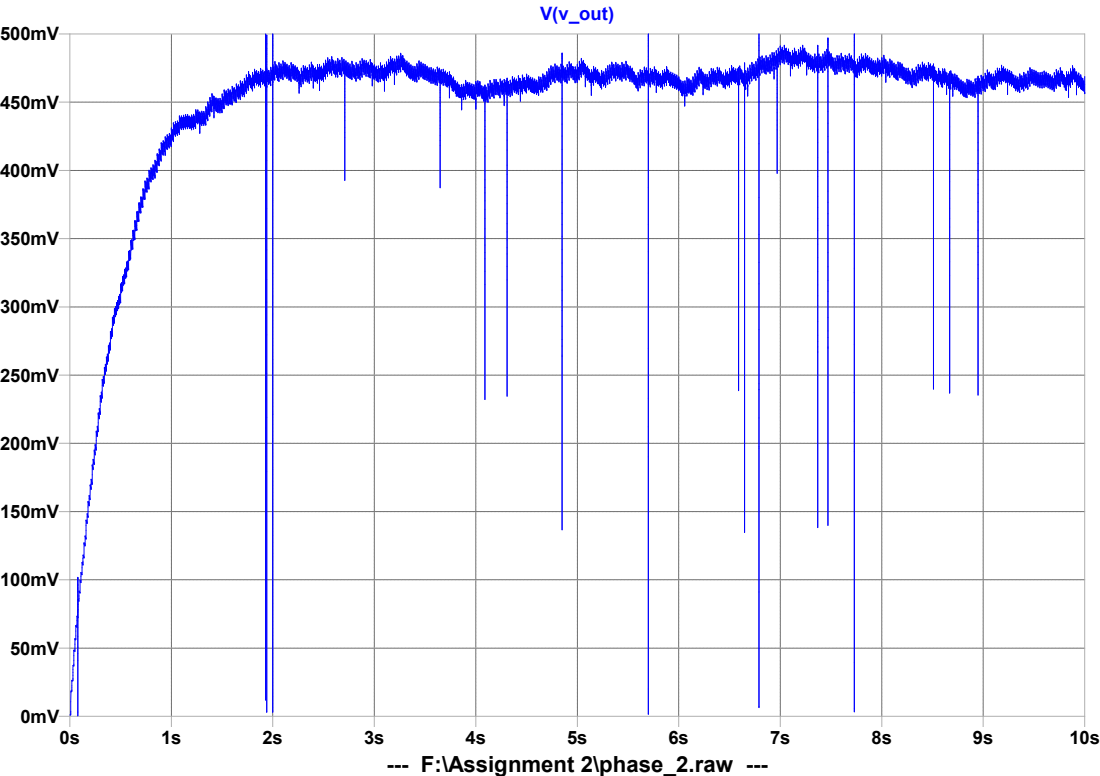
[picture p52: page 1]
V(v_out); --- F:\Assignment 2\phase_2.raw ---
