21317682/E344/Reports/Assignment 2/Figures/phase_transducer_simulation_33u.pdf

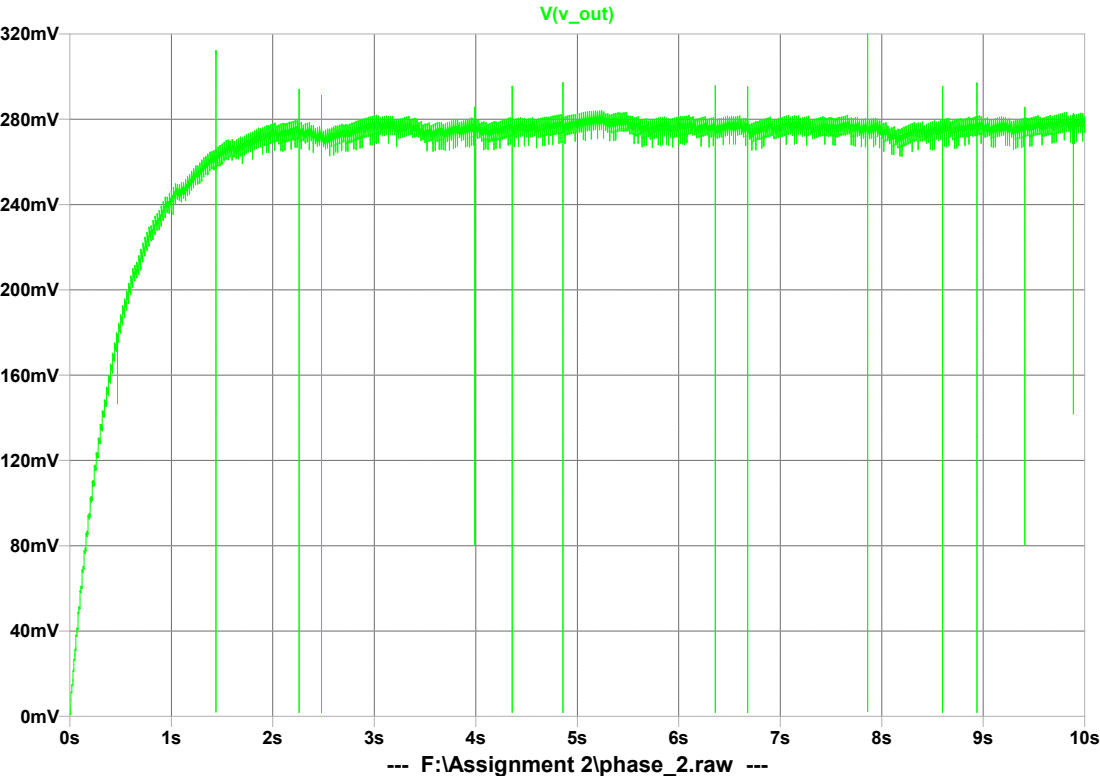
[picture p53: page 1]
V(v_out); --- F:\Assignment 2\phase_2.raw ---
