21317682/E344/Reports/Assignment 2/Figures/voltage_circuit.pdf

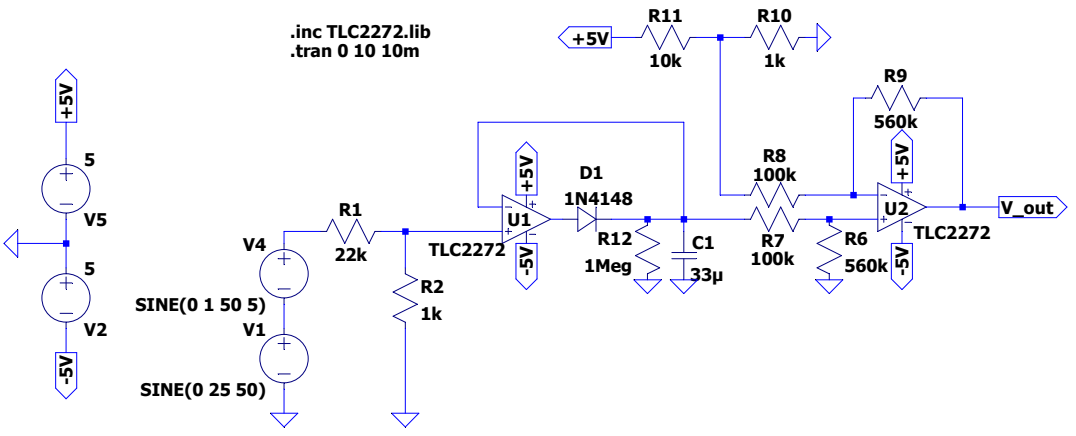
[picture p54: page 1]
