21317682/E344/Reports/Assignment 1/Figures/18v_ac_supply.pdf

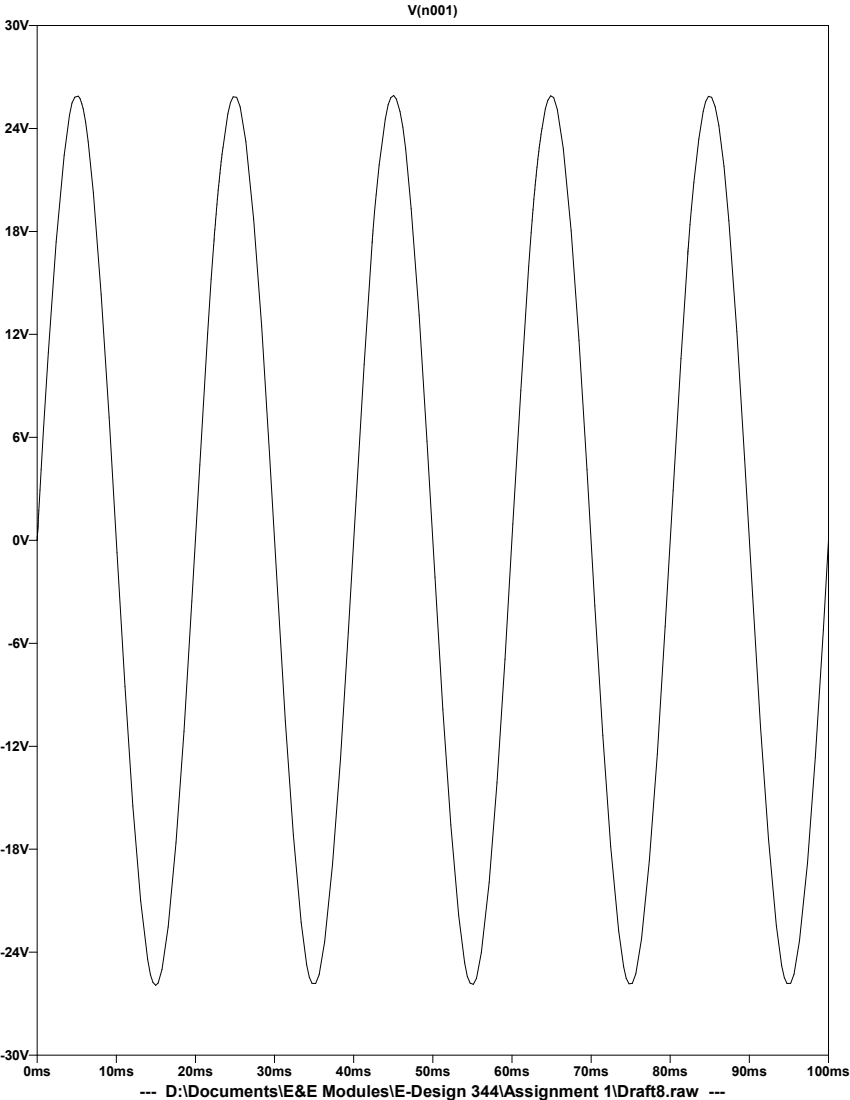
[picture p55: page 1]

--- D:\Documents\E&E Modules\E-Design 344\Assignment 1\Draft8.raw ---
