21317682/E344/Reports/Assignment 1/Figures/chargepump_circuit.pdf

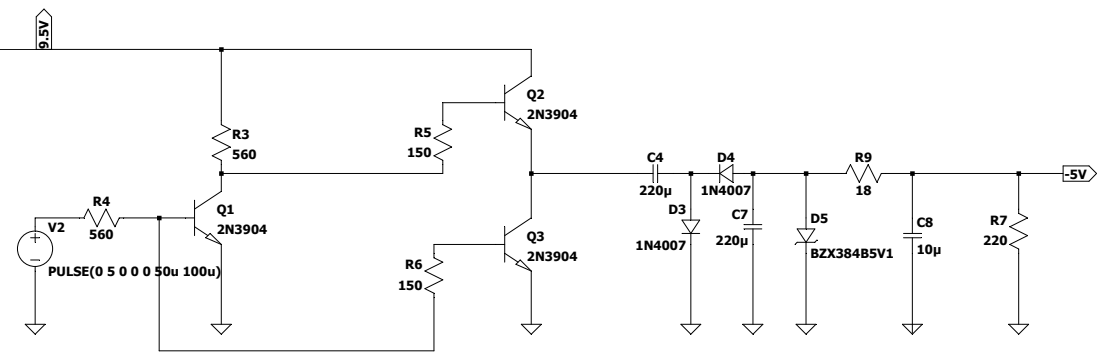
[picture p56: page 1]
