21317682/E344/Reports/Assignment 1/Figures/chargepump_simulate.pdf

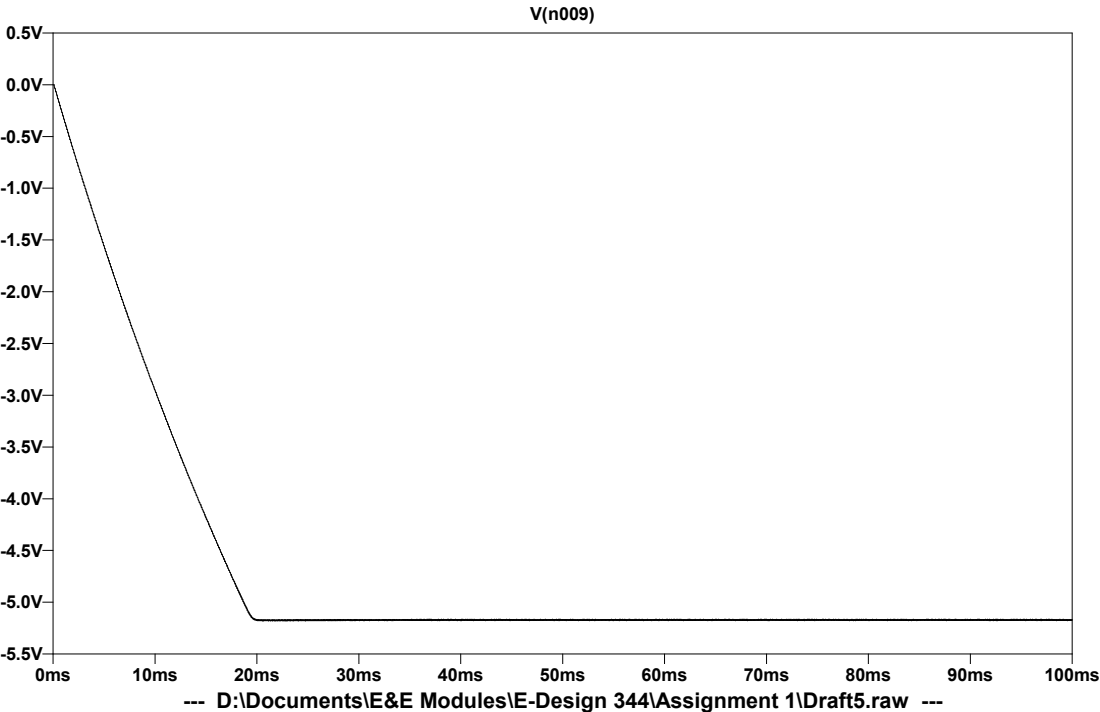
[picture p57: page 1]

--- D:\Documents\E&E Modules\E-Design 344\Assignment 1\Draft5.raw ---
