21317682/E344/Reports/Assignment 1/Figures/rectifier_simulate.pdf

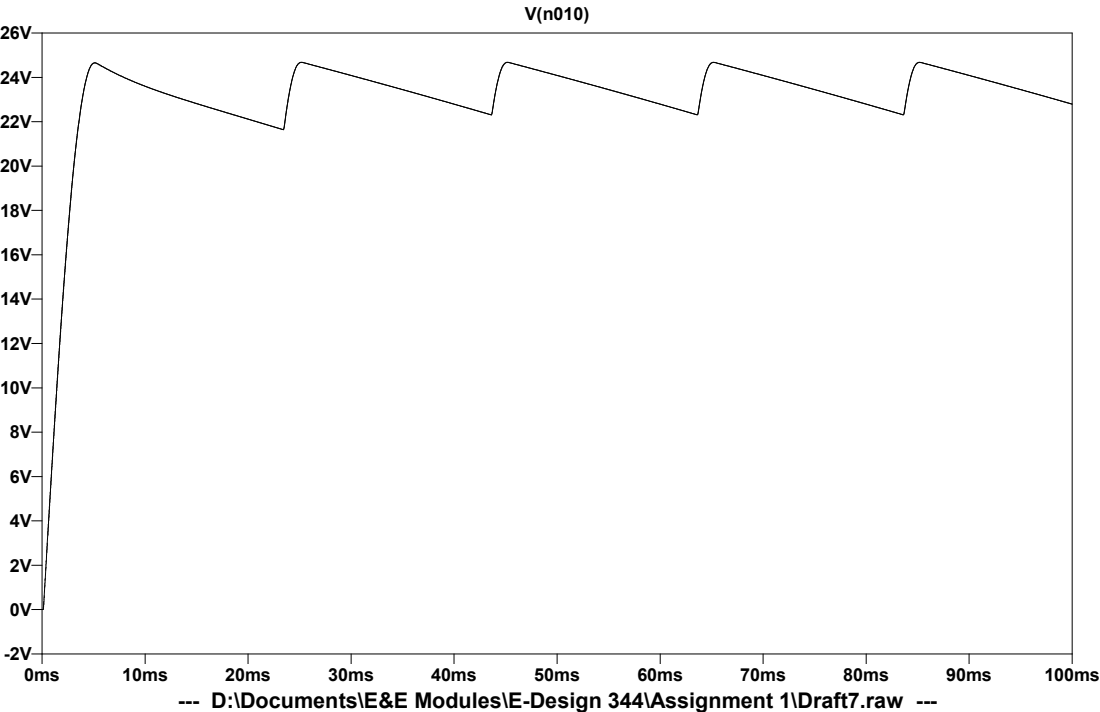
[picture p58: page 1]

--- D:\Documents\E&E Modules\E-Design 344\Assignment 1\Draft7.raw ---
