21317682/E344/Reports/Assignment 1/Figures/result7.pdf

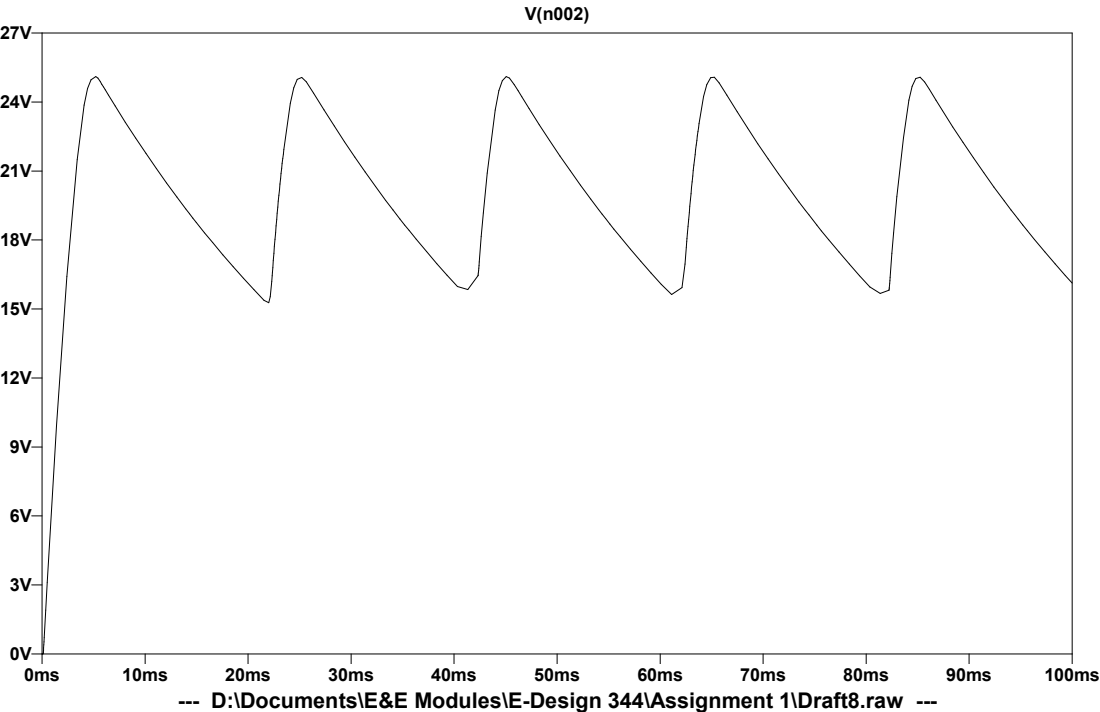
[picture p62: page 1]

--- D:\Documents\E&E Modules\E-Design 344\Assignment 1\Draft8.raw ---
