21317682/E344/Reports/Assignment 1/Figures/switchmode_circuit.pdf

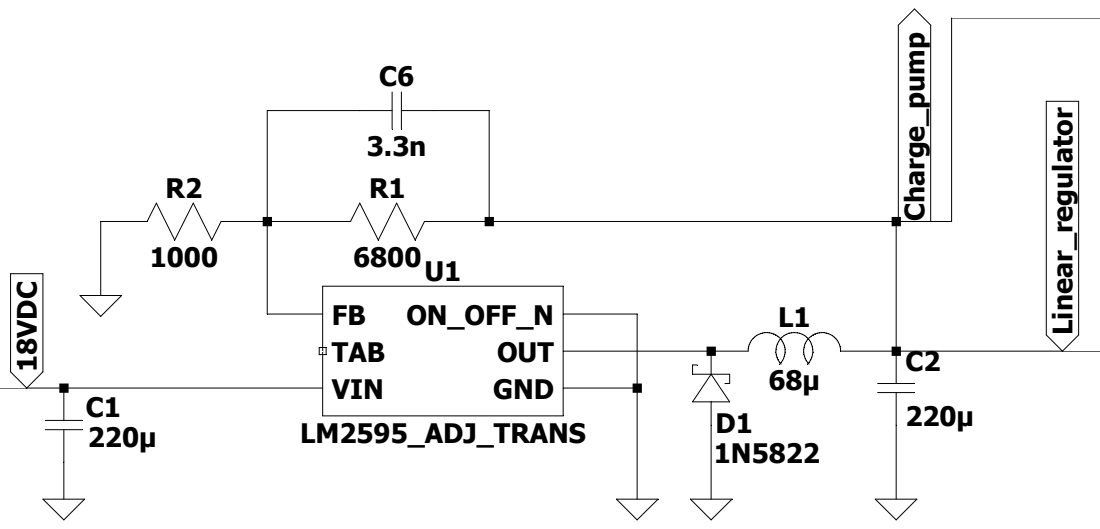
[picture p63: page 1]
