21317682/E344/Reports/Assignment 1/Figures/switchmode_simulate.pdf

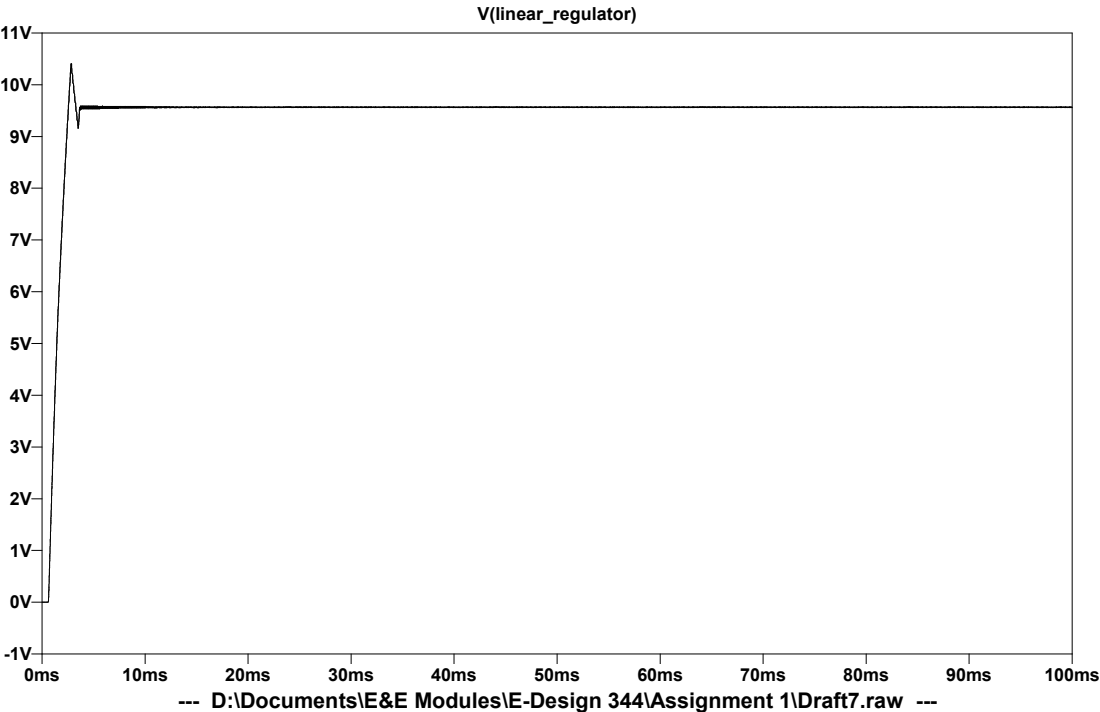
[picture p64: page 1]
V(linear_regulator)

--- D:\Documents\E&E Modules\E-Design 344\Assignment 1\Draft7.raw ---
