21317682/E344/Reports/Assignment 2/Figures/e-design_pwr_ac.pdf

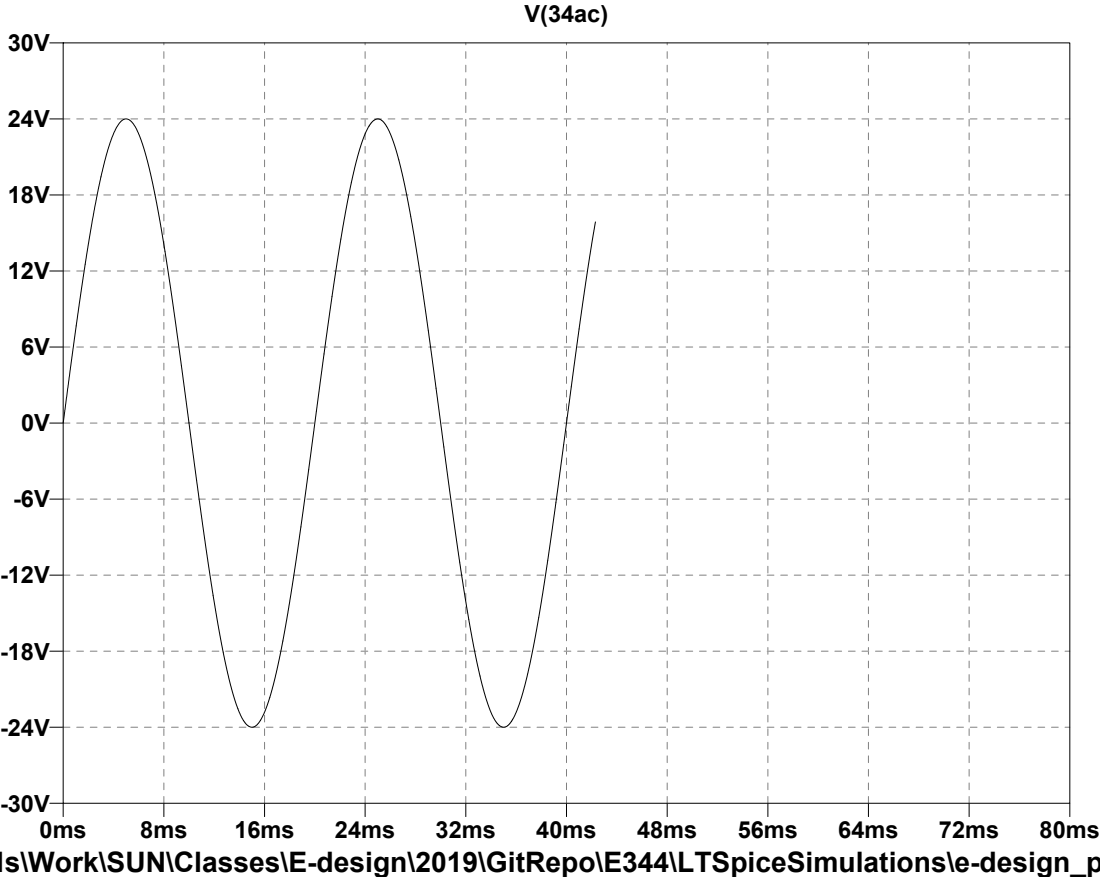
[picture p65: page 1]

ls\Work\SUN\Classes\E-design\2019\GitRepo\E344\LTSpiceSimulations\e-design_p
