21317682/E344/LTSpice/Muthua_21317682_A1.asc

C1: cap; 220µ; V=25
C2: cap; 220µ; V=35
C3: cap; 220µ
C4: cap; 220µ
C5: cap; 0.1µ
C6: cap; 3.3n
C7: cap; 220µ
C8: cap; 100µ
D1: schottky; 1N5822
D2: diode; 1N4007
D3: diode; 1N4007
D4: diode; 1N4007
D5: zener; BZX384B5V1
L1: ind; 68µ
Q1: npn; 2N3904
Q2: npn; 2N3904
Q3: npn; 2N3904
R1: res; 6800
R2: res; 1000
R3: res; 560
R4: res; 560
R5: res; 150
R6: res; 150
R9: res; 18
U1: LM2595_ADJ_TRANS
U2: LM7805
V1: voltage; SINE(0 26 50)
V2: voltage; PULSE(0 5 0 0 0 50u 100u)
Named nets: 0, 5V, -5V, 9.5V, 18VDC
.tran 0 100m 0 1m
.inc LM2595_ADJ_TRANS.lib
.inc LM78XX_RS.lib
Half-Wave Rectifier
SwitchMode Regulator
Linear Regulator
Charge Pump
