21317682/E344/LTSpice/Muthua_21317682_A2.asc

C1: cap; 33µ
C2: cap; 33µ
C3: cap; 1µ
C4: cap; 22µ
D1: diode; 1N4148
D2: diode; 1N4148
D3: diode; 1N4148
D4: diode; 1N4148
I1: current; SINE(0 100m 50)
I2: current; SINE(0 10m 50 5)
R1: res; 22k
R2: res; 1k
R3: res; 560k
R4: res; 100k
R5: res; 100k
R6: res; 560k
R7: res; 1k
R8: res; 10k
R9: res; 1Meg
R10: res; 5.6k
R11: res; 3.3k
R12: res; 1Meg
R13: res; 30m
R14: res; 180k
R15: res; 1k
R16: res; 22k
R17: res; 2.2k
R18: res; 470k
R19: res; 1k
R20: res; 30m
R21: res; 4.7k
R22: res; 2.2k
R23: res; 180k
R24: res; 1k
R25: res; 100k
R26: res; 1k
U1: opamp2; TLC2272
U2: opamp2; TLC2272
U3: opamp2; TLC2272
U4: opamp2; TLC2272
U6: XOR_2
U7: opamp2; TLC2272
U8: opamp2; TLC2272
U9: opamp2; TLC2272
U10: opamp2; TLC2272
V1: voltage; SINE(0 21 50)
V2: voltage; SINE(0 1 50 5)
V3: voltage; 5
V4: voltage; 5
V5: voltage; SINE(0 26 50 0 0 0)
Named nets: 0, +5V, -5V, Voltage_Transducer, Current_Transducer, +50mV, V_in, I_in, I_sense, Phase_Shift_Transducer
Voltage Transducer
Current Transducer
Phase Shift Transducer
.tran 0 10 0 10m
.inc TLC2272.lib
