21317682/E344/LTSpice/Muthua_21317682_A3.asc

C1: cap; 33µ
D1: diode; 1N4148
I1: current; SINE(0 100m 50)
I2: current; SINE(0 10m 50 5)
Q1: npn; 2N3904
Q2: npn; 2N3904
R1: res; 330
R2: res; 1k
R3: res; 22k
R4: res; 2.2k
R5: res; 2.2k
R6: res; 10k
R7: res; 10k
R8: res; 10k
R9: res; 10k
R10: res; 5.6k
R11: res; 3.3k
R12: res; 33k
R13: res; 1Meg
R14: res; 30m
R15: res; 180k
R16: res; 1k
U1: opamp2; TLC2272
U2: MOC3020
U3: opamp2; TLC2272
U4: opamp2; TLC2272
V1: voltage; SINE(0 26 50)
V2: voltage; 5
V3: voltage; PWL(0 0 2.8 0 3 5 5 5)
V5: voltage; PWL(0 0 0.5 0 1.0 0 1.95 0 2.0 5 2.5 5 3.0 5 3.95 5 4.0 0 4.45 0 4.5 5 4.9 5 5 0)
V6: voltage; PWL(0 5 0.01 0 0.95 0 1.0 5 1.95 5 2.0 0 2.95 0 3.0 0 3.95 0 4.0 0 4.95 0 5.0 5 6.9 5 7 0)
V7: voltage; 5
Named nets: 0, 5V, Vin, Set, Reset, Q, Qo, A, -5V, S, +5V, Current_Transducer
.inc MOC302x.lib
.inc BT134.lib
.tran 0 10 0 10m
.inc TLC2272.lib
Current Transducer
SR Latch
Opto-Coupling TRIAC / AC Switch
Overcurrent Trip Set
