21317682/E344/(commit log)

2019-08-04 Create Draft6.asc
    Draft of +5v supply
2019-08-11 Final Assignment 1 schematic
    Final Assignment 1 schematic
2019-09-12 Assignment 2 first push
    Voltage and current peak transducers.
    Already built, not tested
2019-09-22 Final Assignment 2 schematics.
    Simulated, built and tested.
    Report in progress.
2019-10-20 Assignment 3 submission
    A# LTspice files
    Combined all A2 spice files
    Edited A1 spice files
    Also added Python and Arduino code for A3
